teraknights/Pinkeybd-forked/other/README.md

# Pinkeybd
"Pinkeybd" is a portable wireless split keyboard with trackball
