teraknights/Pinkeybd-forked/other/docs/partslist_jp.md

## 1. パーツリスト

## 1.1 内容物

| 部品名 | 数量 | 通常版 | 組み立て済み版 | 最小構成版 |
| ---- | ----: | :----: | :----: | :----: |
| Pinkeybd 左手用基板 |1 | 〇 | ◎ | 〇 |
| Pinkeybd 右手用基板 |1 | 〇 | ◎ | 〇 |
| 左手用キーボードケース |1 | 〇 | ◎ | × |
| 右手用キーボードケース |1 | 〇 | ◎ | × |
| Seeed XIAO BLE nRF52840 |2 | × | ◎ | × |
| PMW3610 ブレイクアウトボード SEIBOKU（青墨） |1 | × | ◎ | × |
| PMW3610DM-SUDU |1 | × | ◎ | × |
| PMW3610DM Sensor With lens |1 | × | ◎ | × |
| THQWGD001 組み立て部品セット |1 | × | ◎ | × |
| XCL103使用3.3V出力昇圧DCDCコンバーターキット |2 | 〇 | ◎ | × |
| スライドスイッチ 1回路2接点 基板用 横向き |2 | 〇 | ◎ | 〇 |
| PHコネクター ベース付ポスト サイド型 2P S2B-PH-K-S |2 | 〇 | ◎ | 〇 |
| PHコネクター ハウジング 2P PHR-2 |2 | 〇 | ◎ | 〇 |
| PHコネクター コンタクト SPH-002T-P0.5L|4 | 〇 | ◎ | 〇 |
| チップ積層セラミックコンデンサー 47μF6.3V X5R 1608 |2 | 〇 | ◎ | 〇 |
| チップ積層セラミックコンデンサー 1μF6.3V X5R 1005 |2 | 〇 | ◎ | 〇 |
| カーボン抵抗(炭素皮膜抵抗) 1/4W 1MΩ |2 | 〇 | ◎ | 〇 |
| Wheel Encoder |1 | 〇 | ◎ | 〇 |
| Button Touch switch 6x6x7 |1 | 〇 | ◎ | 〇 |
| Cherry MX互換キースイッチ向けのキーソケット |35 | 〇 | ◎ | × |
| Kailh Choc V1向けのキーソケット |6 | 〇 | ◎ | × |
| 高速スイッチング・ダイオード 1N4148W |64 | 〇 | ◎ | × |
| トラックボールケース |1 | 〇 | 〇 | × |
| シャフトφ1.5 5mm |3 | 〇 | 〇 | 〇 |
| 電池カバー |2 | 〇 | ◎ | × |
| 電池ボックス 単3×1本 リード線 |2 | 〇 | ◎ | 〇 |
| 電源スイッチカバー |2 | 〇 | ◎ | × |
| マグネット 3mm × 2mm |32 | 〇 | 〇 | × |
| M2ネジ 6mm |6 | 〇 | ◎ | × |
| M2ネジ 8mm |14 | 〇 | ◎ | × |
| M2ナット |10 | 〇 | ◎ | ×
