teraknights/Pinkeybd-forked/other/case/Common/power_switch_cover.step

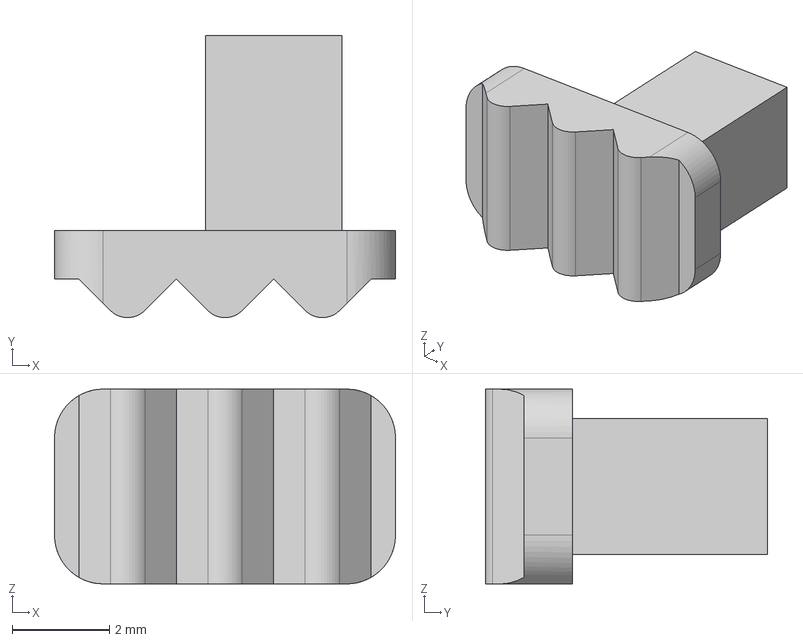
[picture p1: CAD file, 2026-01-10]
other/case/Common/power_switch_cover.step
7.00 x 5.79 x 4.00 mm
