teraknights/Pinkeybd-forked/other/case/Left/pinkeybd_L_ver2.1_top_plate.step

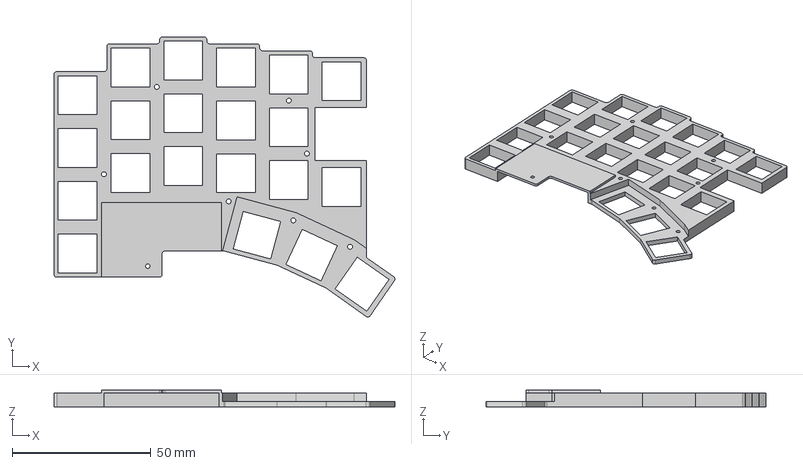
[picture p2: CAD file, 2026-01-10]
other/case/Left/pinkeybd_L_ver2.1_top_plate.step
123.0 x 101.1 x 6.00 mm
