teraknights/Pinkeybd-forked/other/case/Right/pinkeybd_R_ver2.1_bottom_case.step

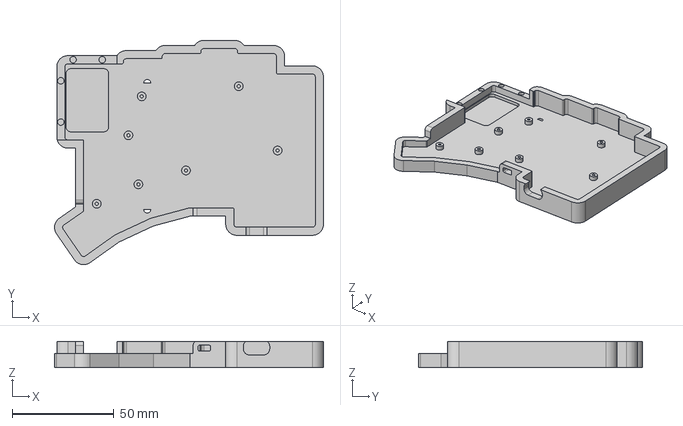
[picture p3: CAD file, 2026-01-10]
other/case/Right/pinkeybd_R_ver2.1_bottom_case.step
132.0 x 110.1 x 13.0 mm
