teraknights/Pinkeybd-forked/other/case/Common/battery_cover.step

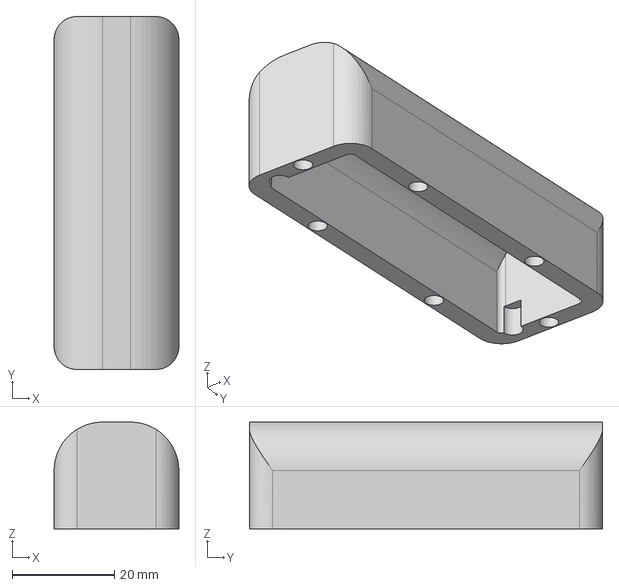
[picture p4: CAD file, 2026-01-10]
other/case/Common/battery_cover.step
24.4 x 69.0 x 20.9 mm
