teraknights/Pinkeybd-forked/other/case/Right/trackball_case.step

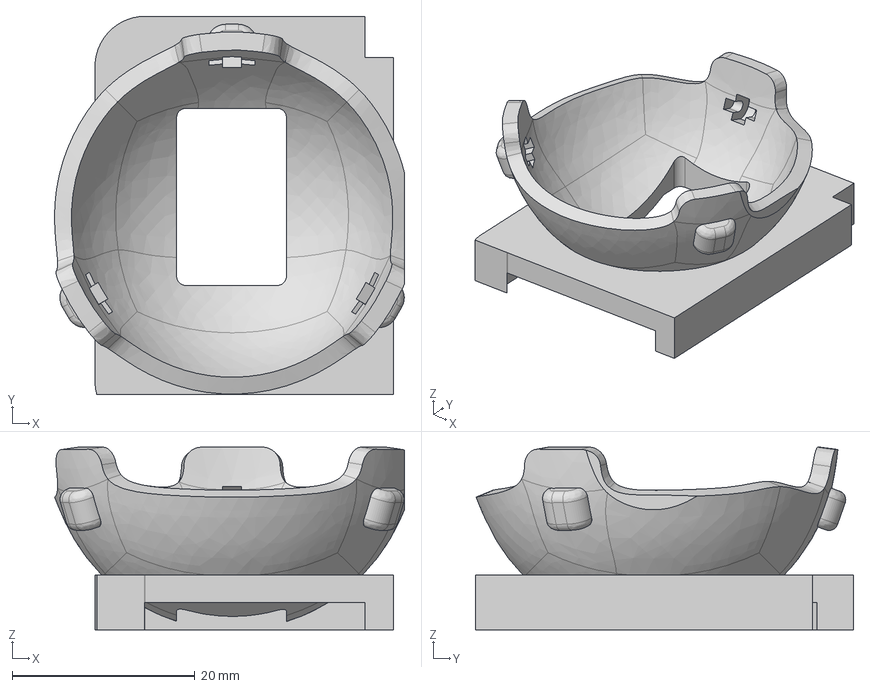
[picture p5: CAD file, 2026-01-10]
other/case/Right/trackball_case.step
38.3 x 41.4 x 20.0 mm
