teraknights/Pinkeybd-forked/(list of files, cad)

Other CAD files:
other/case/Left/pinkeybd_L_ver2.1_bottom_case.step
other/case/Right/pinkeybd_R_ver2.1_top_plate.step
other/case/Common/power_switch_cover.3mf
