teraknights/Pinkeybd-forked/other/docs/buildguide/buildguide_jp.md

Pinkeybdの通常版をご購入いただいた方向けのビルドガイドです。

# 0. 改定履歴
| 日付 | 内容 | 
| :----: | :---- |
| 2025/12/01 | 初版 |

# 1. 目次
- [0. 改定履歴](#0-改定履歴)
- [1. 目次](#1-目次)
- [2. 準備](#2-準備)
  - [2.1 内容物](#21-内容物)
  - [2.2 別途ご準備いただくもの](#22-別途ご準備いただくもの)
  - [2.3 その他あるとよいもの](#23-その他あるとよいもの)
  - [2.4 完成までに必要なもの](#24-完成までに必要なもの)
- [3. 実装](#3-実装)
  - [3.1 ダイオードのはんだ付け](#31-ダイオードのはんだ付け)
  - [3.2 キーソケットのはんだ付け](#32-キーソケットのはんだ付け)
  - [3.3 Xiaoの取り付け](#33-xiaoの取り付け)
  - [3.4 \[3.3V出力昇圧DCDCコンバーター\]の取り付け](#34-33v出力昇圧dcdcコンバーターの取り付け)
  - [3.5 電源スイッチの取り付け](#35-電源スイッチの取り付け)
  - [3.6 セラミックコンデンサの取り付け](#36-セラミックコンデンサの取り付け)
  - [3.7 抵抗の取り付け](#37-抵抗の取り付け)
  - [3.8 PHコネクタの取り付け](#38-phコネクタの取り付け)
  - [3.9 左手基板のロータリーエンコーダ](#39-左手基板のロータリーエンコーダ)
  - [3.10 トラックボール読み取りセンサの取り付け](#310-トラックボール読み取りセンサの取り付け)
  - [3.11 トラックボール読み取り基板の取り付け](#311-トラックボール読み取り基板の取り付け)
- [4. 仮動作確認](#4-仮動作確認)
  - [4.1 ファームウェアダウンロード](#41-ファームウェアダウンロード)
  - [4.2 ファームウェアの書き込み](#42-ファームウェアの書き込み)
  - [4.3 キーの動作確認](#43-キーの動作確認)
- [5. 組み立て](#5-組み立て)
  - [5.1 ボトムケースにマグネットを装着](#51-ボトムケースにマグネットを装着)
  - [5.2 電池ケースの配線](#52-電池ケースの配線)
  - [5.3 ボトムケースの準備](#53-ボトムケースの準備)
  - [5.4 基板とケースの組み立て](#54-基板とケースの組み立て)
  - [5.5 電池カバーケース](#55-電池カバーケース)
  - [5.6 電源スイッチカバー](#56-電源スイッチカバー)
  - [5.7 トラックボールケース](#57-トラックボールケース)
- [6. キースイッチとキーキャップ](#6-キースイッチとキーキャップ)
- [7. Bluetooth接続](#7-bluetooth接続)
- [8. ファームウェアの書き換えとキーマップ変更](#8-ファームウェアの書き換えとキーマップ変更)
- [9. トラブルシューティング](#9-トラブルシューティング)
- [10. Discordサーバ](#10-discordサーバ)

# 2. 準備
キットの内容物と別途準備いただくものを確認してください。

## 2.1 内容物
[パーツリスト](https://github.com/ktkhshi/Pinkeybd/blob/main/docs/partslist_jp.md)を参照ください。

## 2.2 別途ご準備いただくもの
| 部品名 | 数量 | 主な購入先|
| ---- | ----: | ---- |
|Seeed Xiao BLE nRF52840 | 2 | https://akizukidenshi.com/catalog/g/g117341/ |
|PMW3610 ブレイクアウトボード SEIBOKU（青墨） | 1 | https://booth.pm/ja/items/6363907?srsltid=AfmBOooXQEWyThINmj-5S1s9w4ln55OPvNEPTU_EjSfsdfYdSUeQe4cA |
|PMW3610DM-SUDU | 1| https://shop.talpkeyboard.com/products/pmw3610dm-sudu-lm18-lsi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 |
|PMW3610DM Sensor lens | 1 | 同上 |
|THQWGD001 組み立て部品セット | 1 | - |
|はんだごて | 1 | - |
|はんだ | 1 | - |
|ニッパー | 1 | - |
|圧着ペンチ | 1 | - |
|プラスドライバー | 1 | - |
|USB Type-C ケーブル | 1 | - |

## 2.3 その他あるとよいもの
| 部品名 | 数量 |
| ---- | ----: |
|ピンセット| 1|
|フラックス| 1|
|マスキングテープ| 1|
|細ペンチ | 1|

## 2.4 完成までに必要なもの
| 部品名 | 数量 | 主な購入先|
| ---- | ----: | ---- |
|ベアリング 内径 1.5mm 外径 4mm 幅 2mm  | 3 | https://amzn.to/4rdIJV1 |
|トラックボール 34mm  | 1 | https://amzn.to/4iEnzeT |
|キースイッチ | 41 | - |
|キーキャップ | 41 | - |

※Amazonのアソシエイトリンクを含みます

# 3. 実装
## 3.1 ダイオードのはんだ付け
ダイオードの向きに注意して、はんだ付けをします。
先に基盤の片側どちらかに予備はんだをしておき、予備はんだを溶かしながらつけていくとよいです。
ダイオードの数が多いですが、向きを間違えないように気を付けて行います。
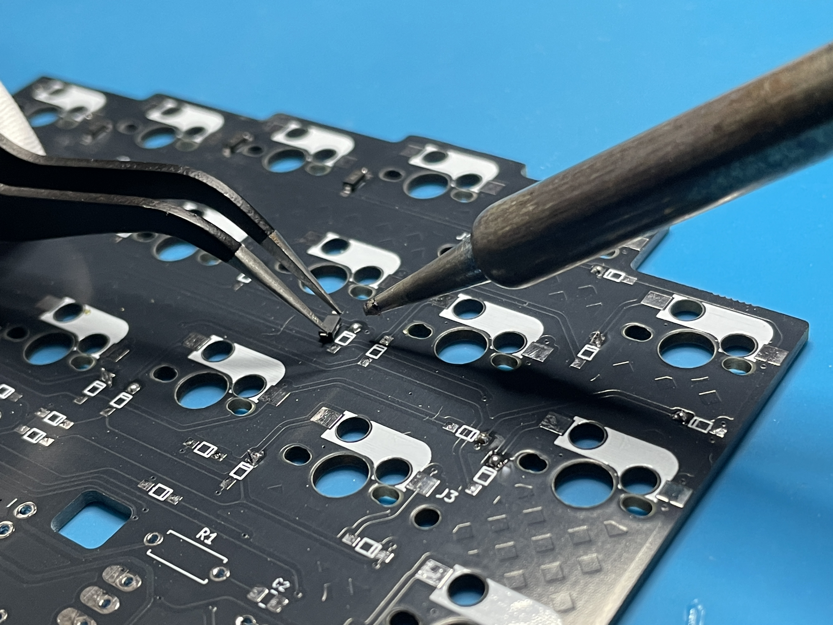
[picture p6: other/docs/buildguide/image/IMG_5378.JPG]


## 3.2 キーソケットのはんだ付け
Cherry MX互換キースイッチ向けのキーソケットをはんだ付けします。
こちらは、ソケットの設置箇所に予備はんだをしておき、はんだを溶かしながら押し込むとよいです。
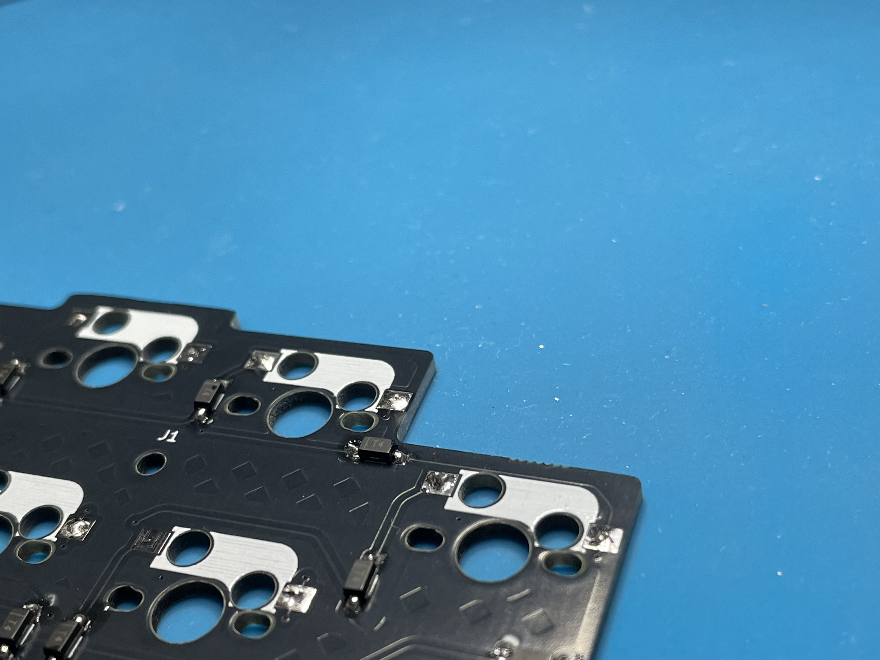
[picture p7: other/docs/buildguide/image/IMG_5383.JPG]


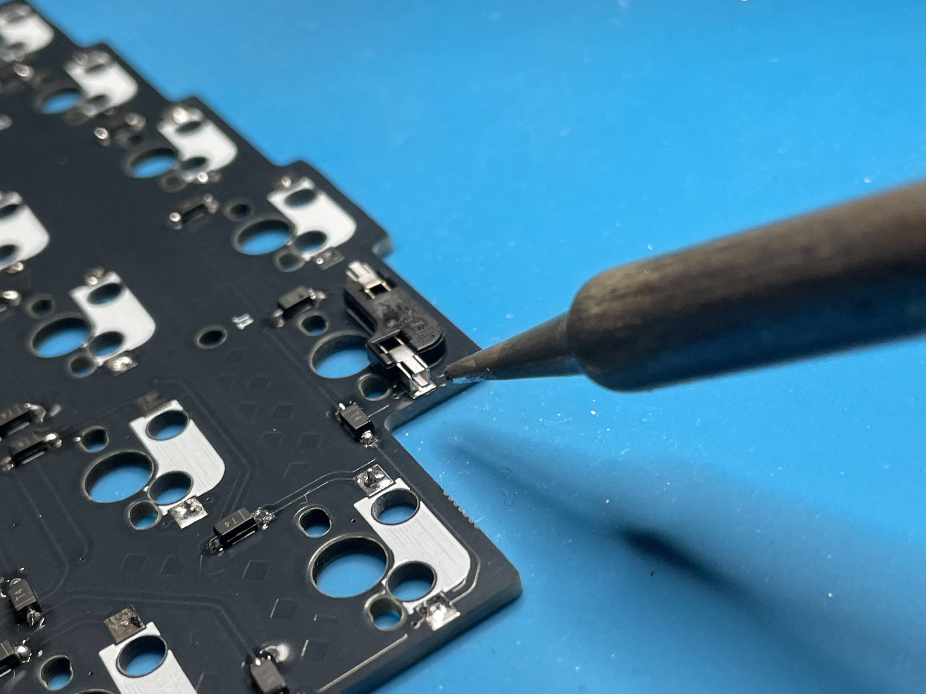
[picture p8: other/docs/buildguide/image/IMG_5384.JPG]


親指部分のKailh Choc V1向けのキーソケットも同様にはんだ付けします。
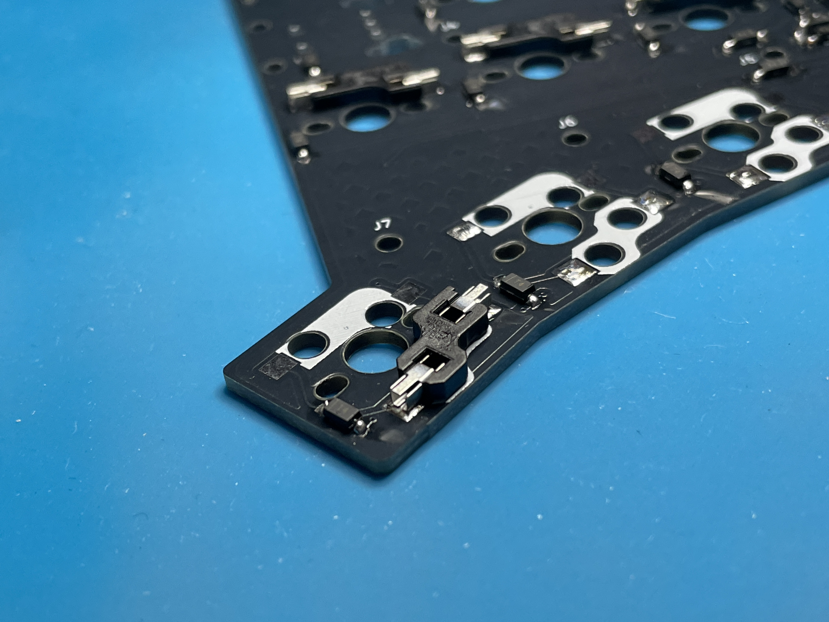
[picture p9: other/docs/buildguide/image/IMG_5388.JPG]


## 3.3 Xiaoの取り付け
基板の表面（ロゴが印字されている面）にSeeed Xiao BLE nRF52840を直接配置しピンヘッダーを差し込んでと固定します。
フラックスがある場合は、Xiaoのピン側面と基板のパッド部分に塗り隅の位置をはんだ付けします。
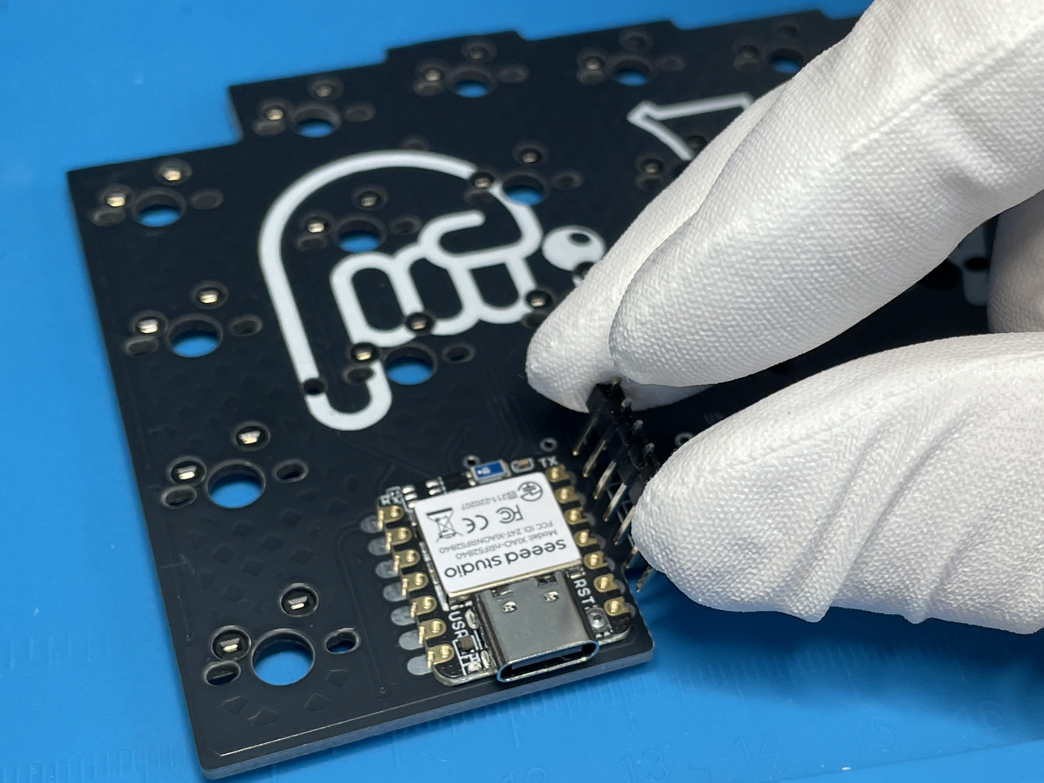
[picture p10: other/docs/buildguide/image/IMG_5402.JPG]


端のだけをはんだ付けしピンヘッダーを抜き、その他のピン部分をはんだ付けします。

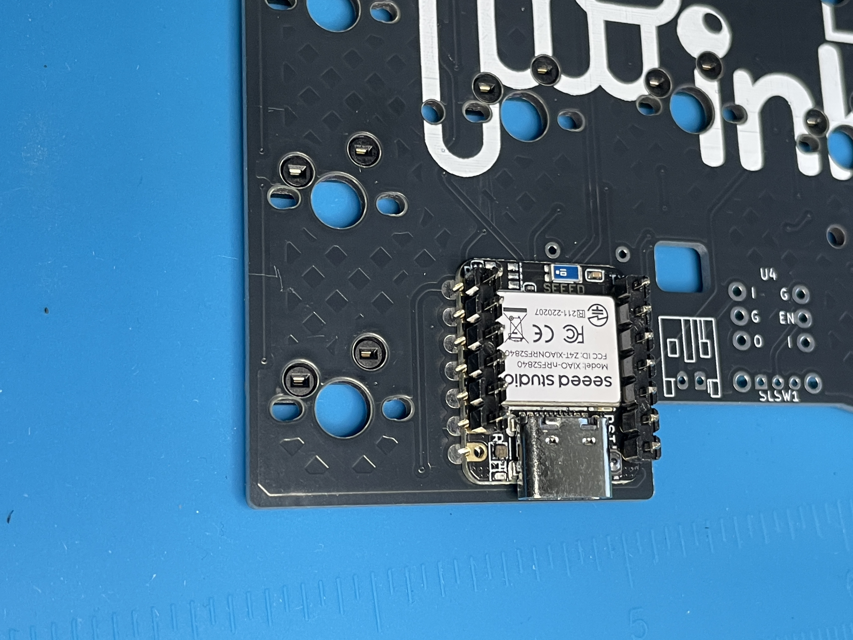
[picture p11: other/docs/buildguide/image/IMG_5409.JPG]


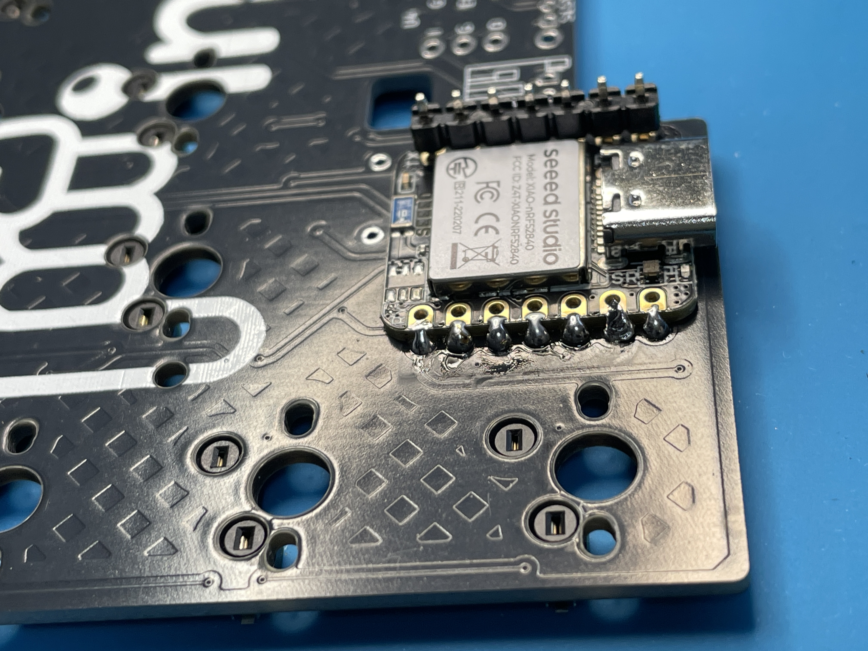
[picture p12: other/docs/buildguide/image/IMG_5416.JPG]


裏面の電源ピンのはんだ付けをします。フラックスがある場合は、フラックスをしっかり塗ってからはんだ付けします。すこし基板を傾けながら行うとやりやすいです。
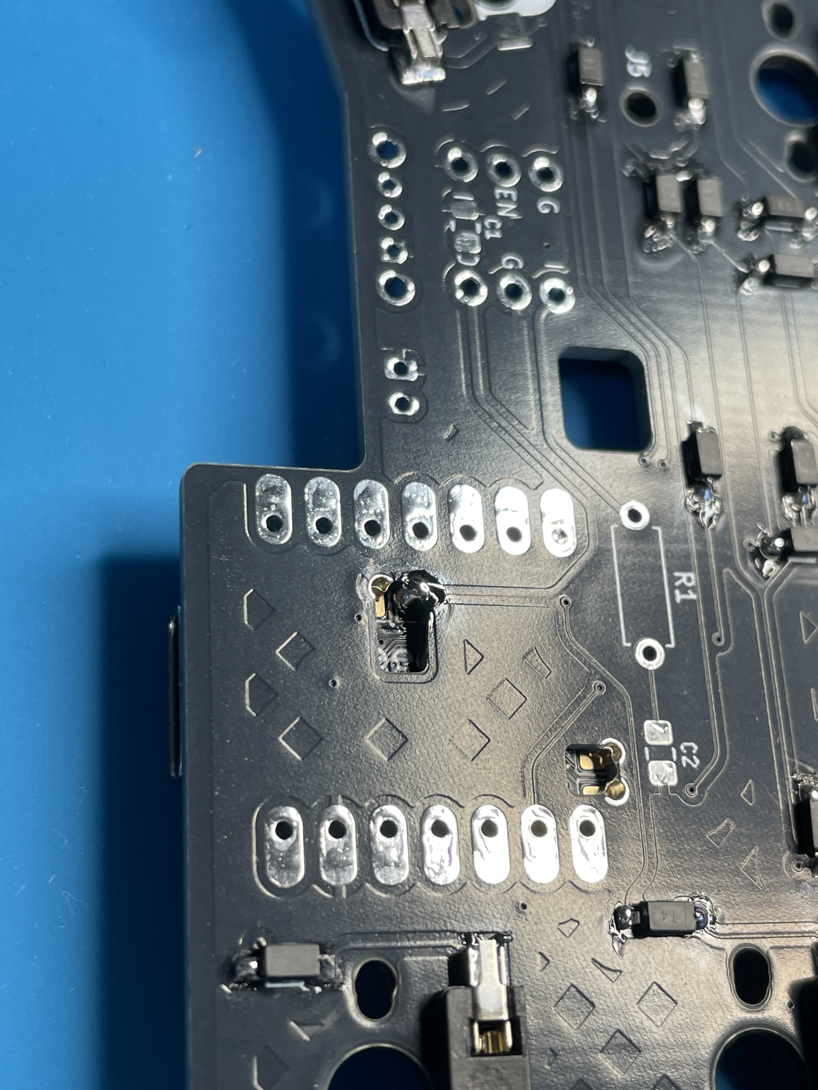
[picture p13: other/docs/buildguide/image/IMG_5421.JPG]


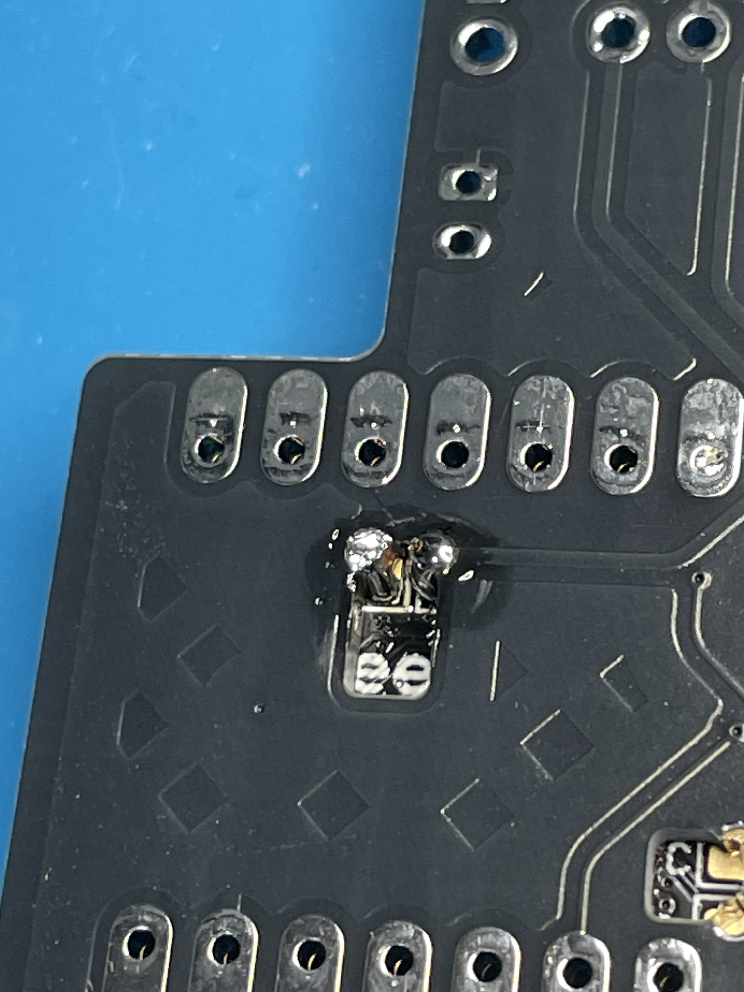
[picture p14: other/docs/buildguide/image/IMG_5423.JPG]


## 3.4 [3.3V出力昇圧DCDCコンバーター]の取り付け
ピンヘッダーを使用して3.3V出力昇圧DCDCコンバーターを基板の表面（ロゴが印字されている面）に取り付けます。
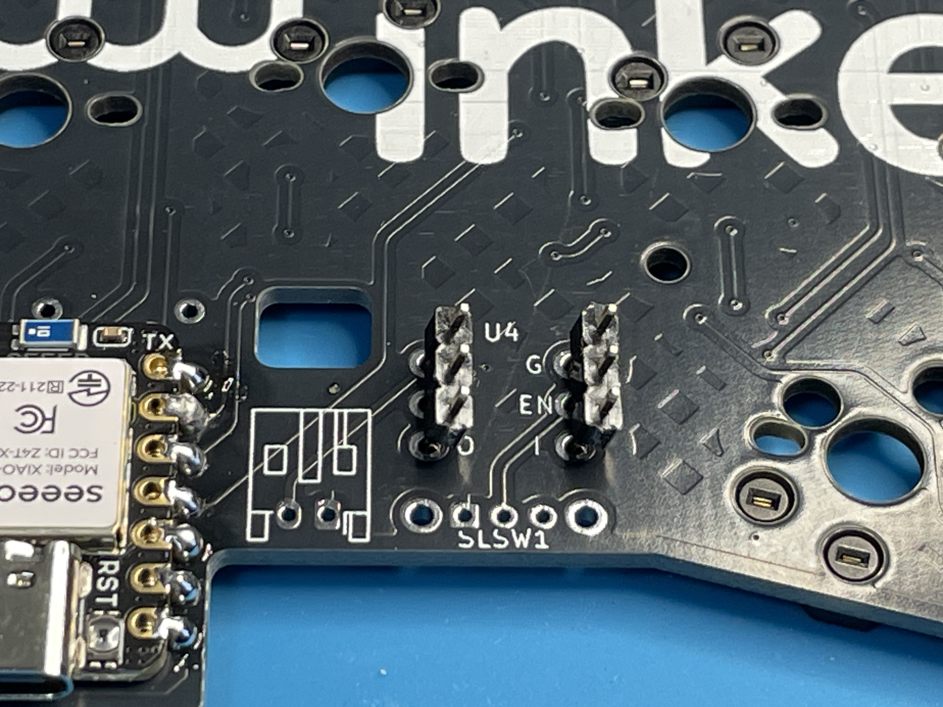
[picture p15: other/docs/buildguide/image/IMG_5424.JPG]


**必ず、基板に印字されているシルクと3.3V出力昇圧DCDCコンバーターのピンが一致していることを確認します。素子が付いている面をPinkeybdのメイン基板にしてください。** マスキングテープで3.3V出力昇圧DCDCコンバーターを固定し、基板の裏面をはんだ付けします。その後、テープを片面ずつ外しながら、3.3V出力昇圧DCDCコンバーターもはんだ付けします。

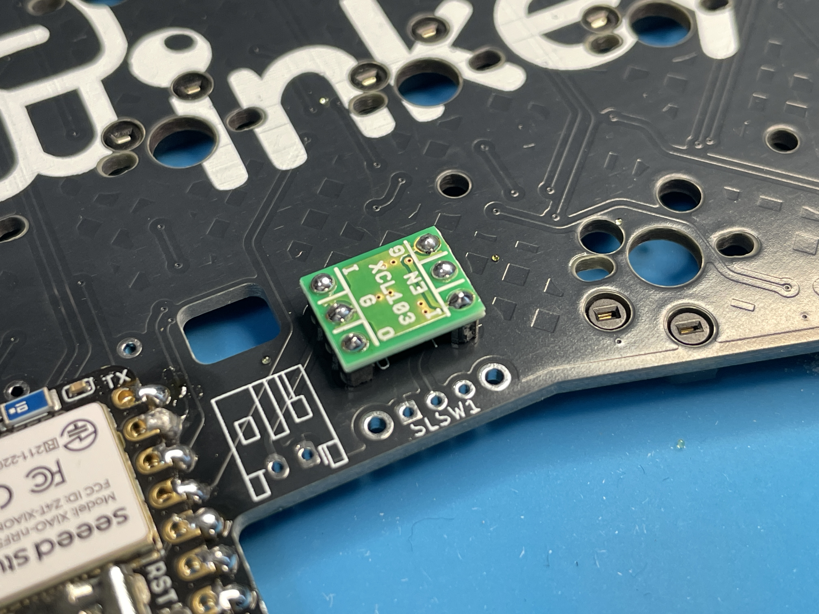
[picture p16: other/docs/buildguide/image/IMG_5432.JPG]


:::note alert 注意
左手基板の右下の「I」のピンははんだ付けしないようにしてください。
※画像では付けしておりますがEN側については、「G」と「EN」ピンのみとしてピンヘッダーを抜いて取り付けを行ってください。
※右手側はすべてのピンをはんだ付けして問題ありません。
:::

## 3.5 電源スイッチの取り付け
スライドスイッチを基板の表面（ロゴが印字されている面）から差し込みマスキングテープで固定して基板に取り付けます。

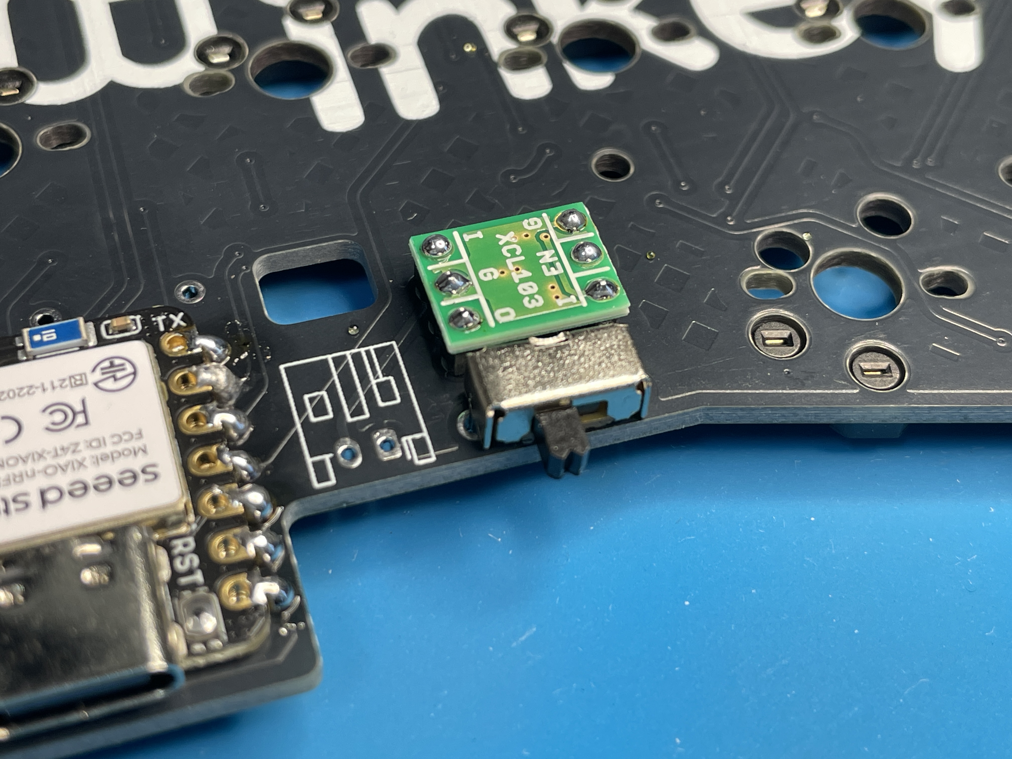
[picture p17: other/docs/buildguide/image/IMG_5435.JPG]


導通していない端の二つ足も固定のためにはんだ付けします。
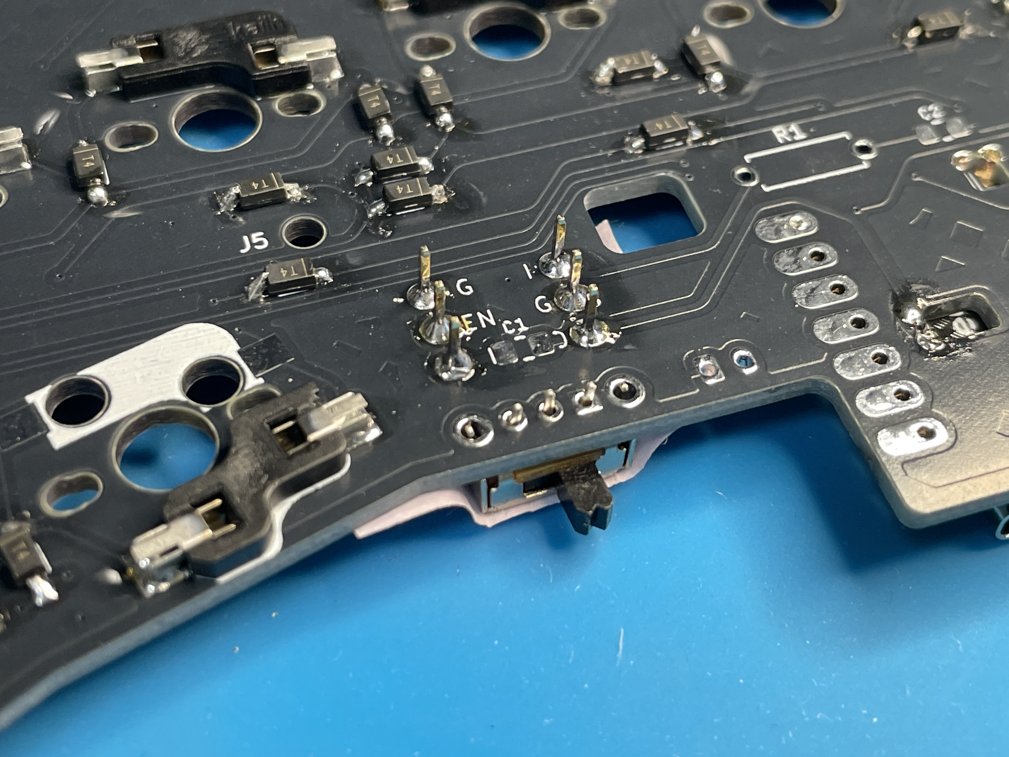
[picture p18: other/docs/buildguide/image/IMG_5437.JPG]


## 3.6 セラミックコンデンサの取り付け
C2の位置に1μFのセラミックコンデンサを取り付けます。
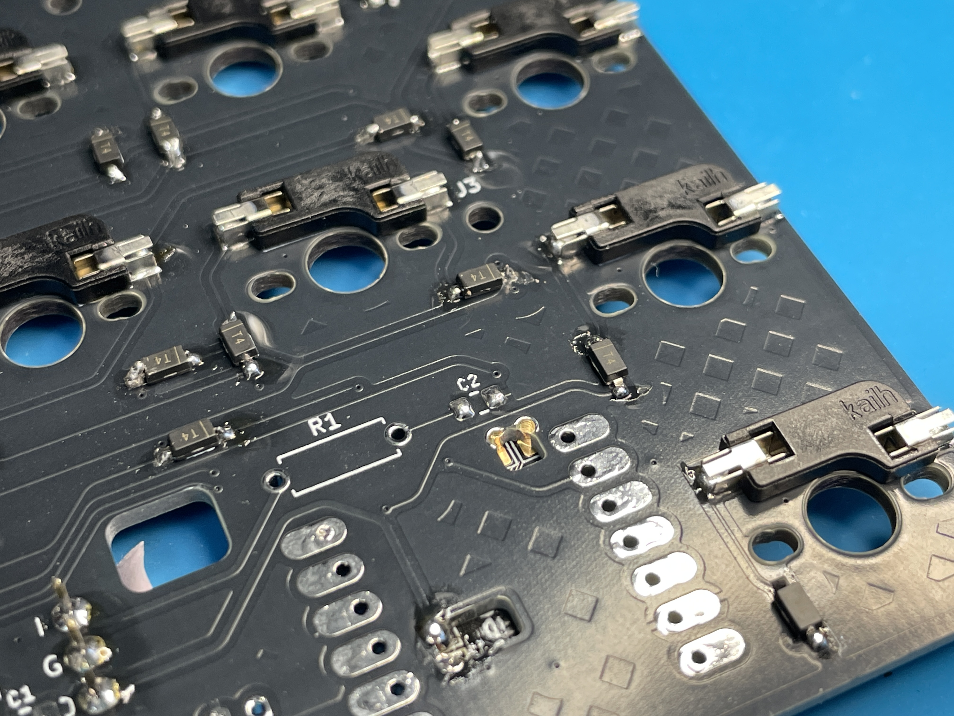
[picture p19: other/docs/buildguide/image/IMG_5439.JPG]


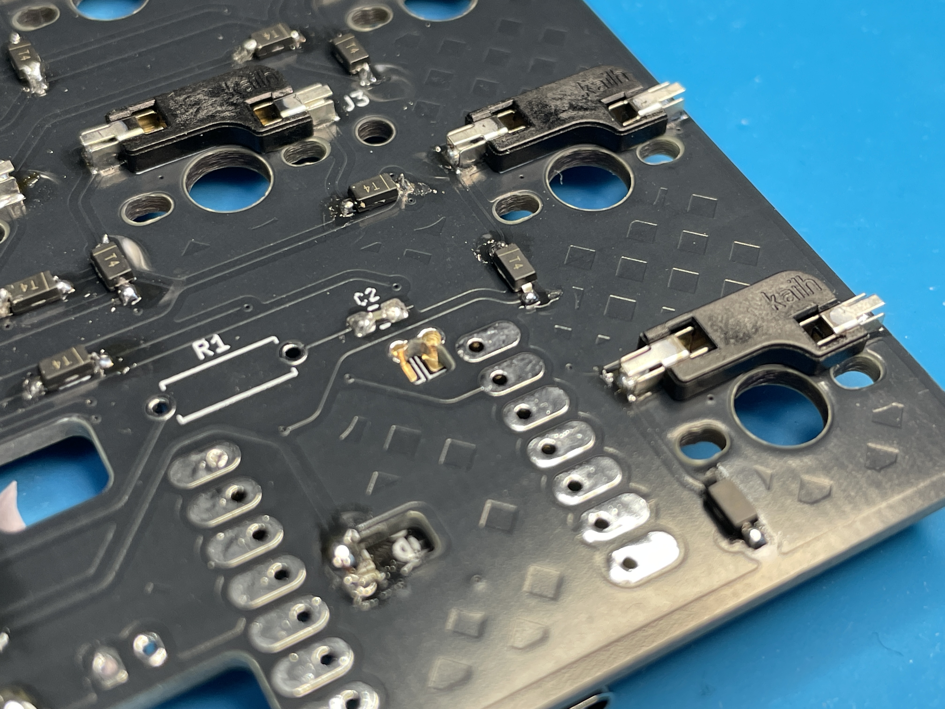
[picture p20: other/docs/buildguide/image/IMG_5440.JPG]
 

C1の位置に47μFのセラミックコンデンサを取り付けます。
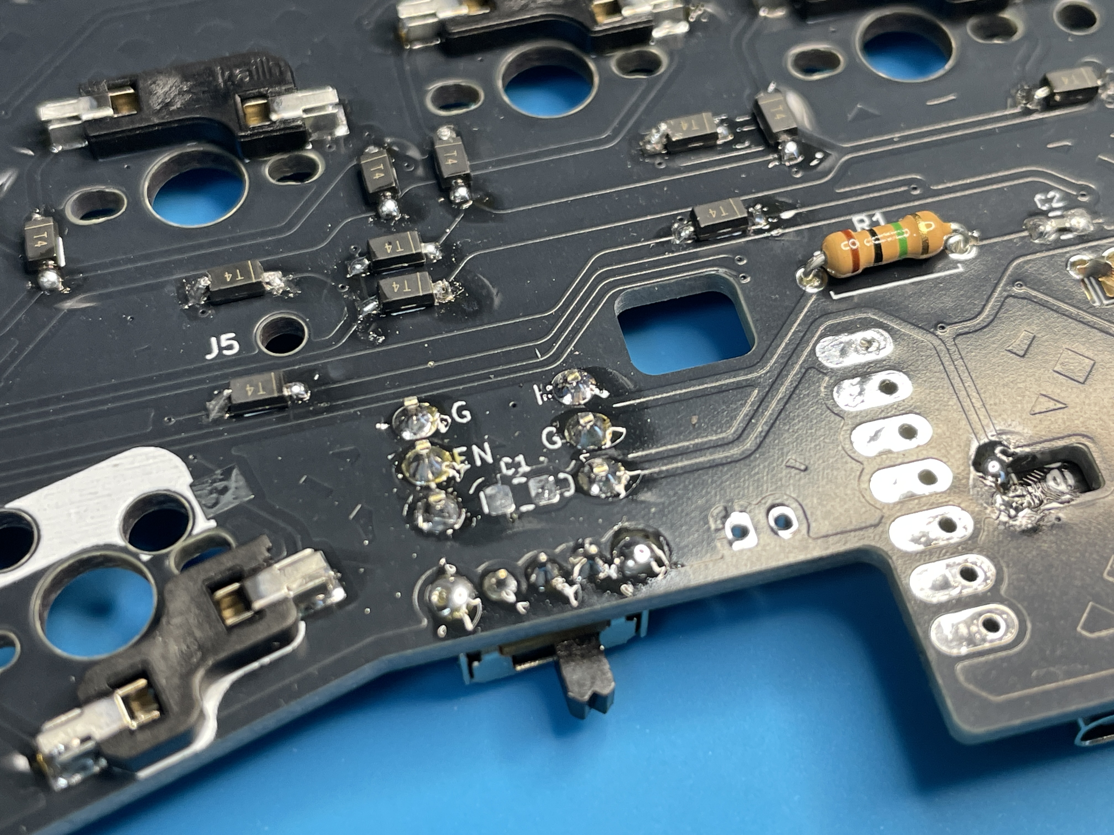
[picture p21: other/docs/buildguide/image/IMG_5449.JPG]


## 3.7 抵抗の取り付け
R1の位置にカーボン抵抗を取り付けます。
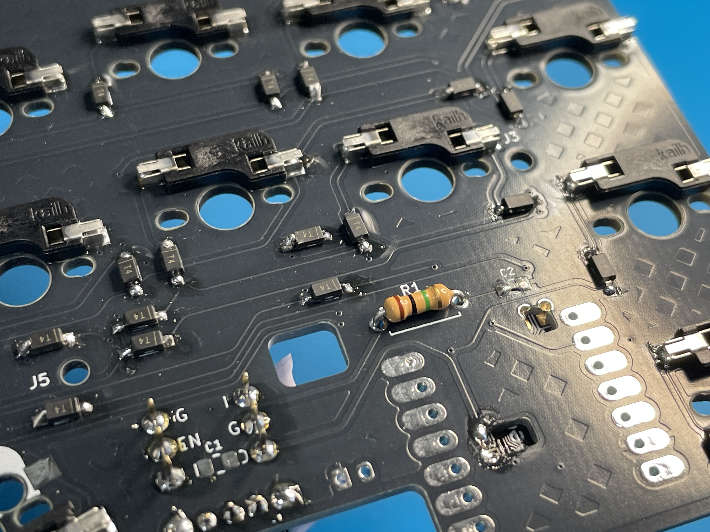
[picture p22: other/docs/buildguide/image/IMG_5444.JPG]

裏面から差し込み、表面ではんだ付けします。

## 3.8 PHコネクタの取り付け
PHコネクター ベース付ポストを基板にシルクの向きに合わせて裏面からはんだ付けします。
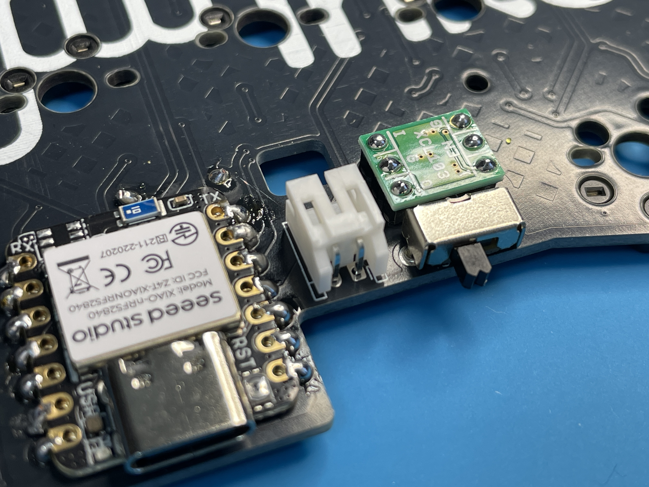
[picture p23: other/docs/buildguide/image/IMG_5452.JPG]


:::note 情報
3.1～3.6は、右手基板と左手基板で共通して行います。
:::

## 3.9 左手基板のロータリーエンコーダ
Wheel Encoderを基板に取り付けます。

先に、ホイールクリックのためのタクトスイッチをはんだ付けします。
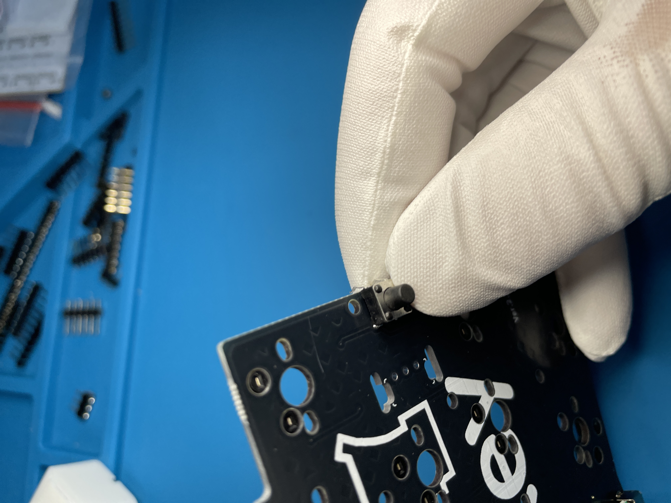
[picture p24: other/docs/buildguide/image/IMG_5457.JPG]

このとき片側の足だけを本体基板に挿し込みますができるだけ内側（基板中心）に寄せます。タクトスイッチがケースと干渉するのは防ぐためです。タクトスイッチのはんだ付けができたら、片側の足２本をニッパで切断します。
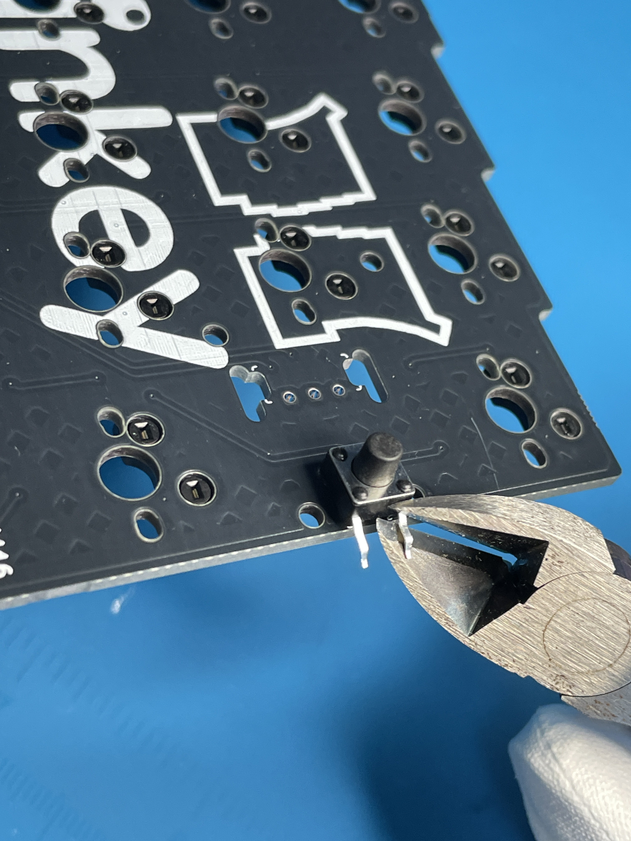
[picture p25: other/docs/buildguide/image/IMG_5461.JPG]


THQWGD001の部品を組み立てて、ナットのM2ねじで左手基板と固定します。
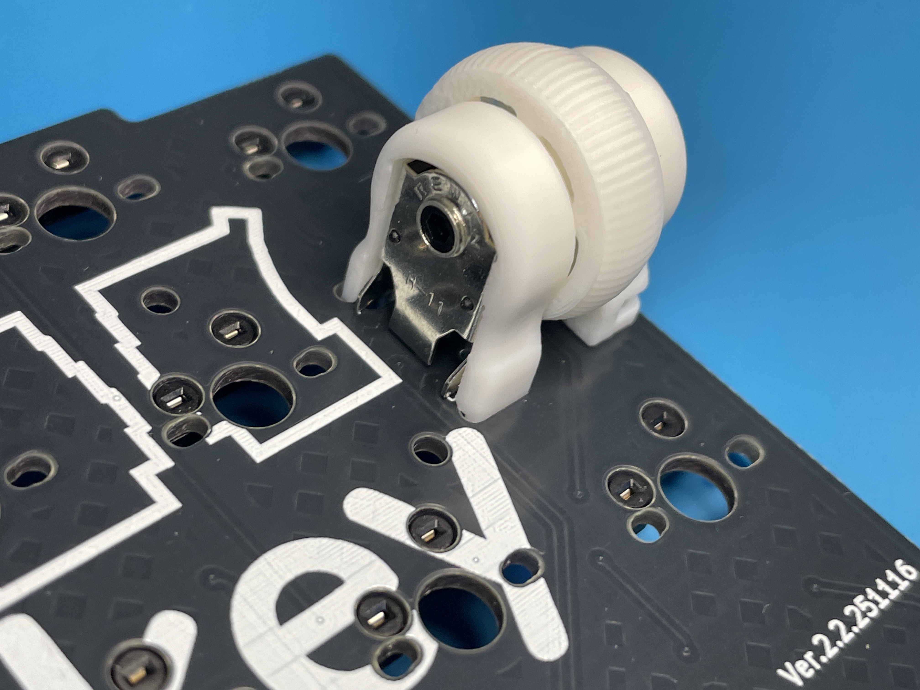
[picture p26: other/docs/buildguide/image/IMG_5463.JPG]


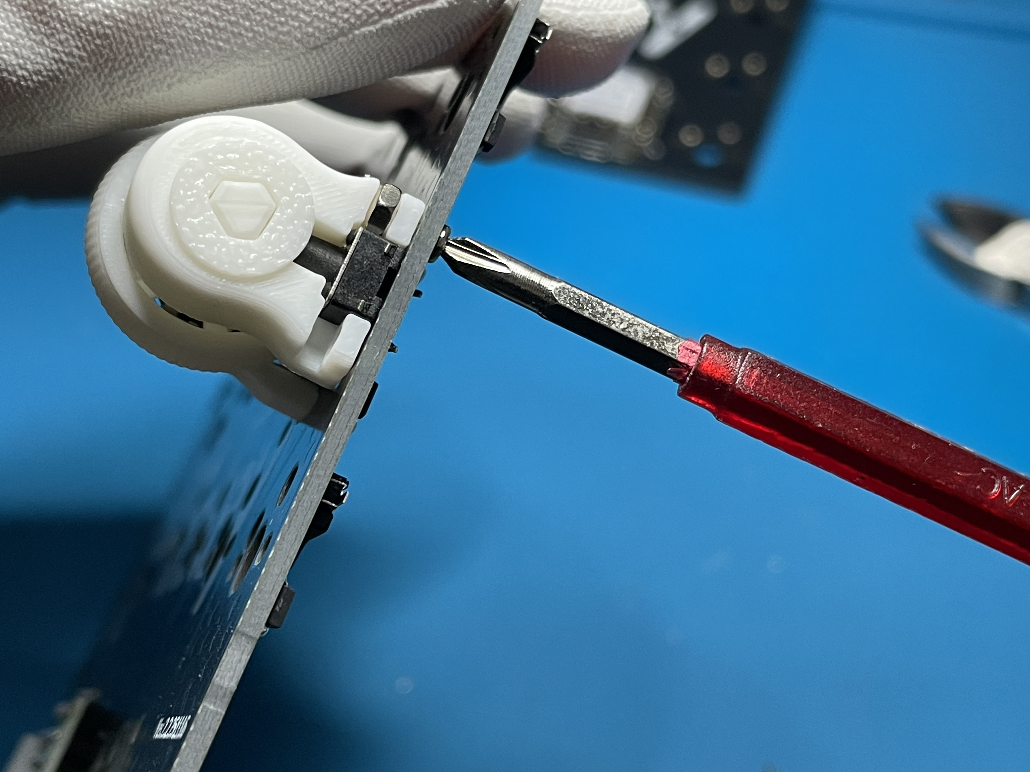
[picture p27: other/docs/buildguide/image/IMG_5510.JPG]


## 3.10 トラックボール読み取りセンサの取り付け
PMW3610 ブレイクアウトボード SEIBOKU（青墨）に、PMW3610DM-SUDUをはんだ付けします。
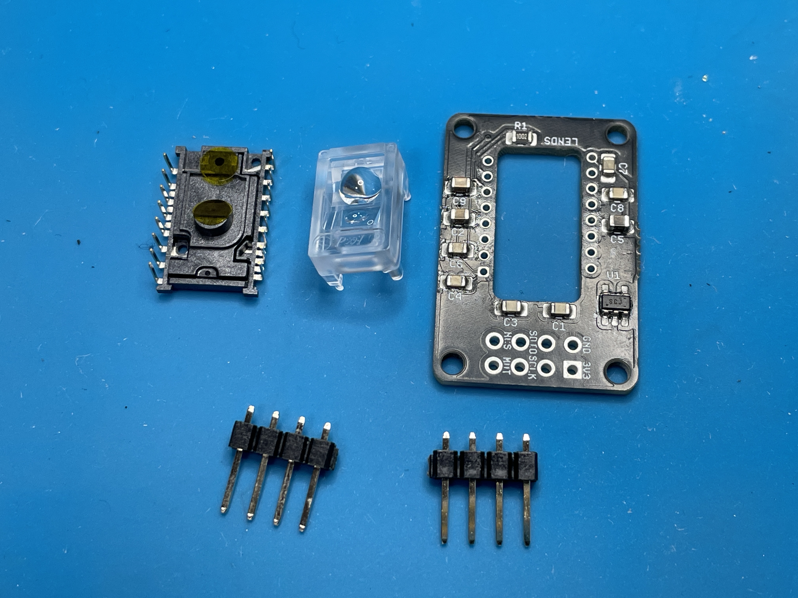
[picture p28: other/docs/buildguide/image/IMG_5491.JPG]


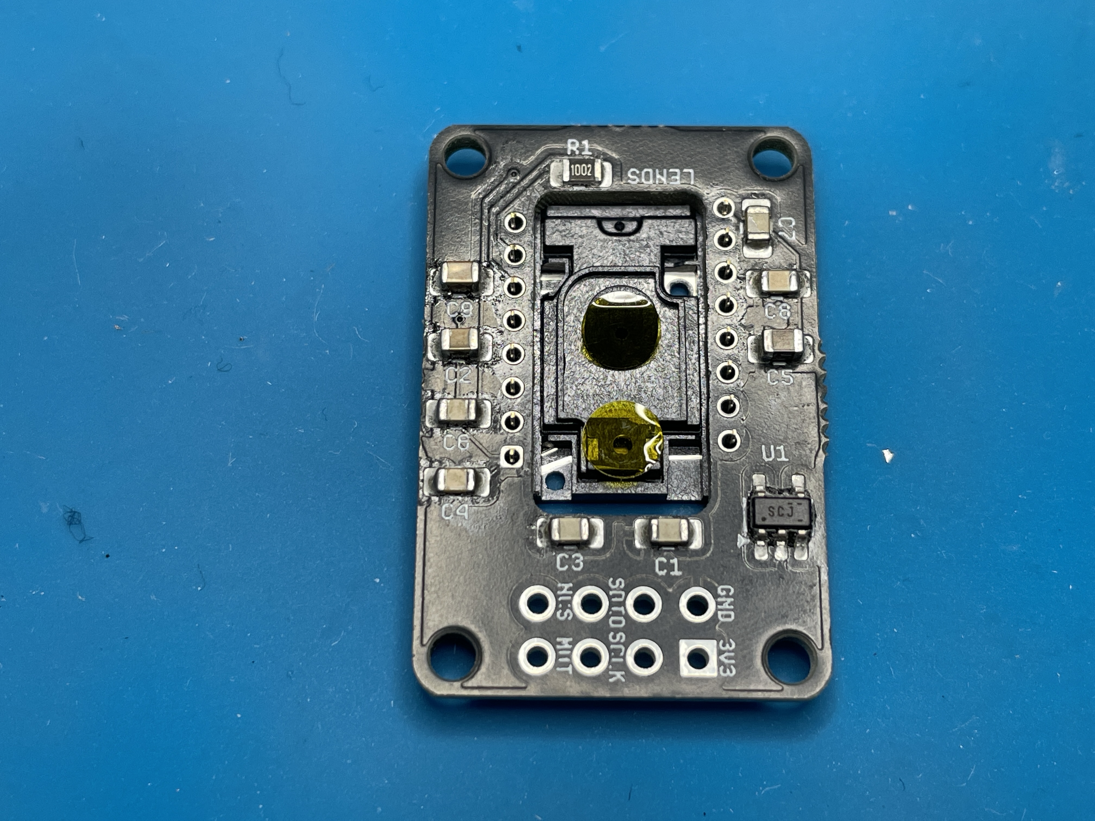
[picture p29: other/docs/buildguide/image/IMG_5493.JPG]

向きを間違えないようにします。はんだづけが完了したら、保護シールを外します。
※キーボードケース取り付け後でも問題ありません。

## 3.11 トラックボール読み取り基板の取り付け
PMW3610 ブレイクアウトボード SEIBOKU（青墨）を右手基板に取り付けます。
PMW3610 ブレイクアウトボード SEIBOKU（青墨）の四隅の穴にM2 8mmネジを通します。
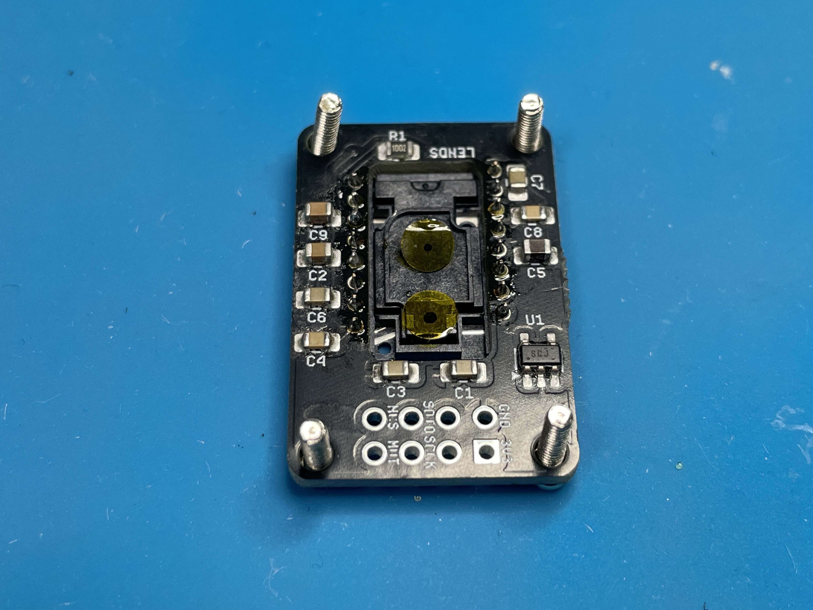
[picture p30: other/docs/buildguide/image/IMG_5494.JPG]


その上からナットを通して仮止めしてします。

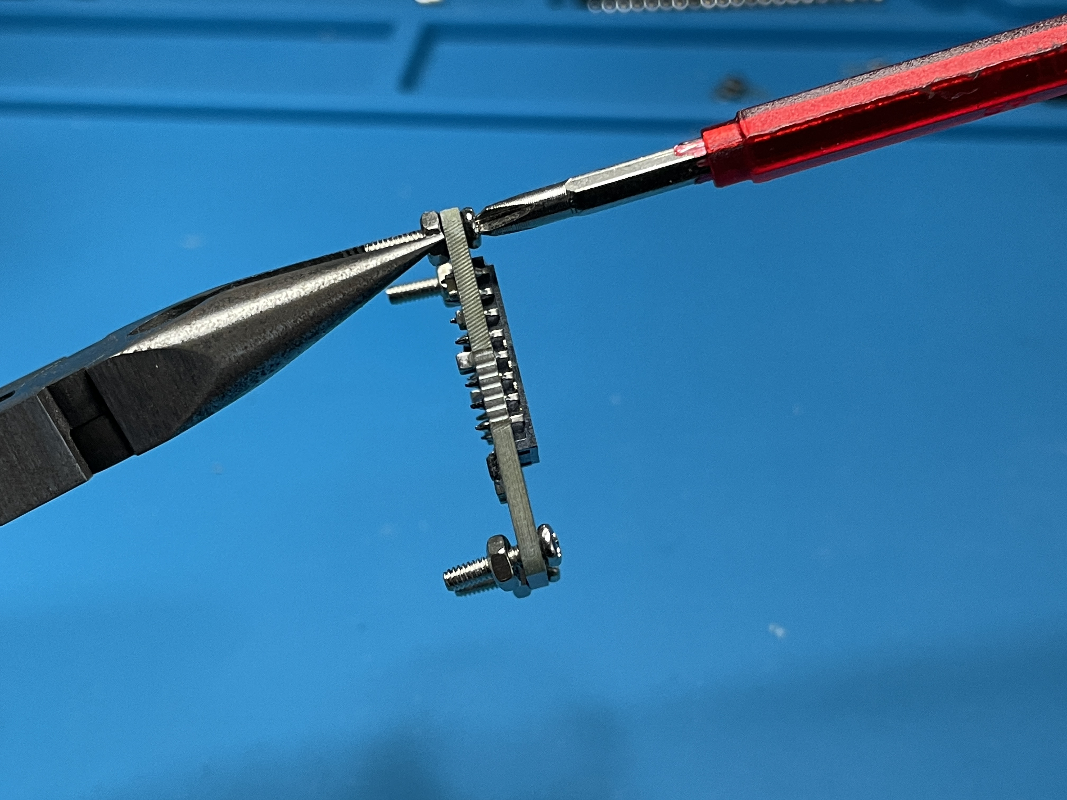
[picture p31: other/docs/buildguide/image/IMG_5497.JPG]


Pinkeybdの右手基板に裏面から差し込み、ナットで仮止めします。
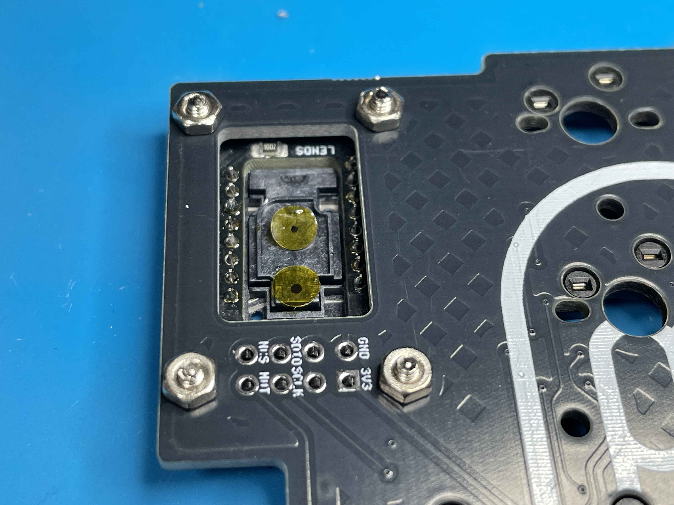
[picture p32: other/docs/buildguide/image/IMG_5500.JPG]


片側が長い４ピンのピンヘッダーを２つ使い右手基板の表面から挿してSEIBOKUのピン穴にも通します。
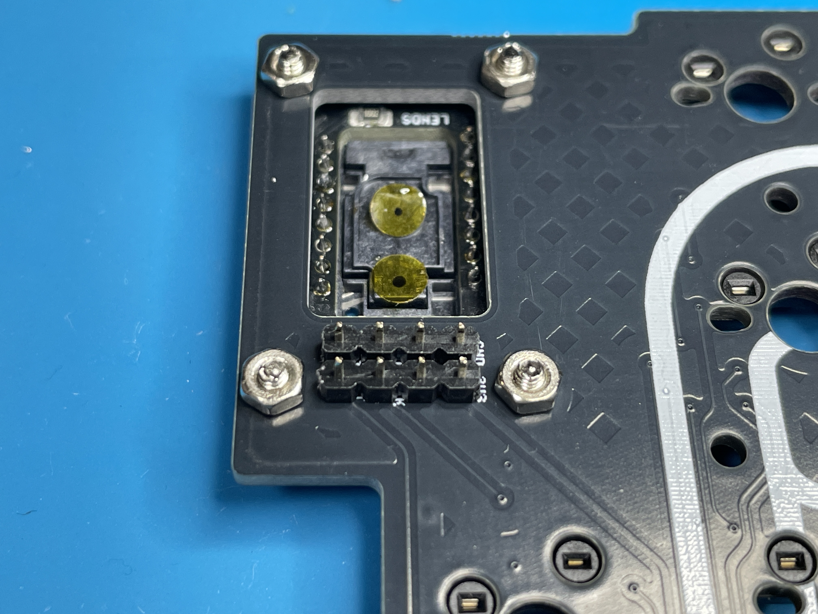
[picture p33: other/docs/buildguide/image/IMG_5502.JPG]


PMW3610 ブレイクアウトボード SEIBOKU（青墨）裏面のピンをはんだづけします。
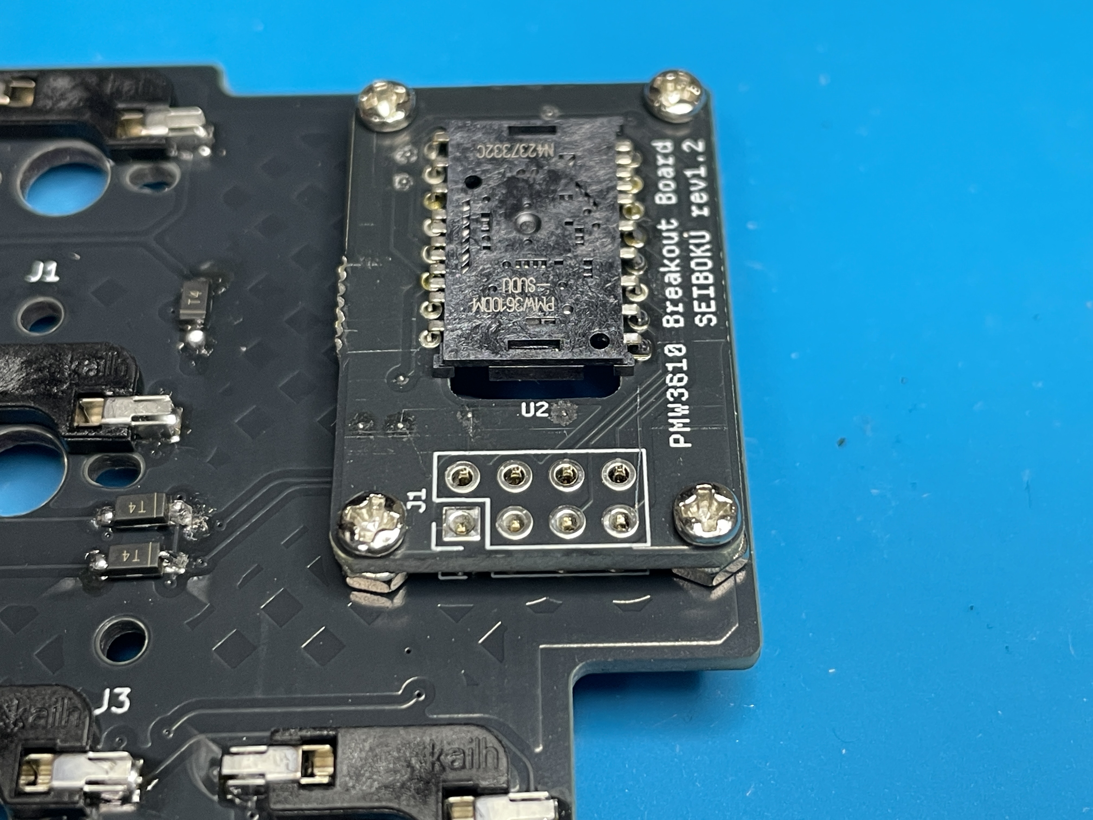
[picture p34: other/docs/buildguide/image/IMG_5504.JPG]


表面にしてピンヘッダーのハウジング（外装）部分を取り外して、基板側もはんだ付けします。
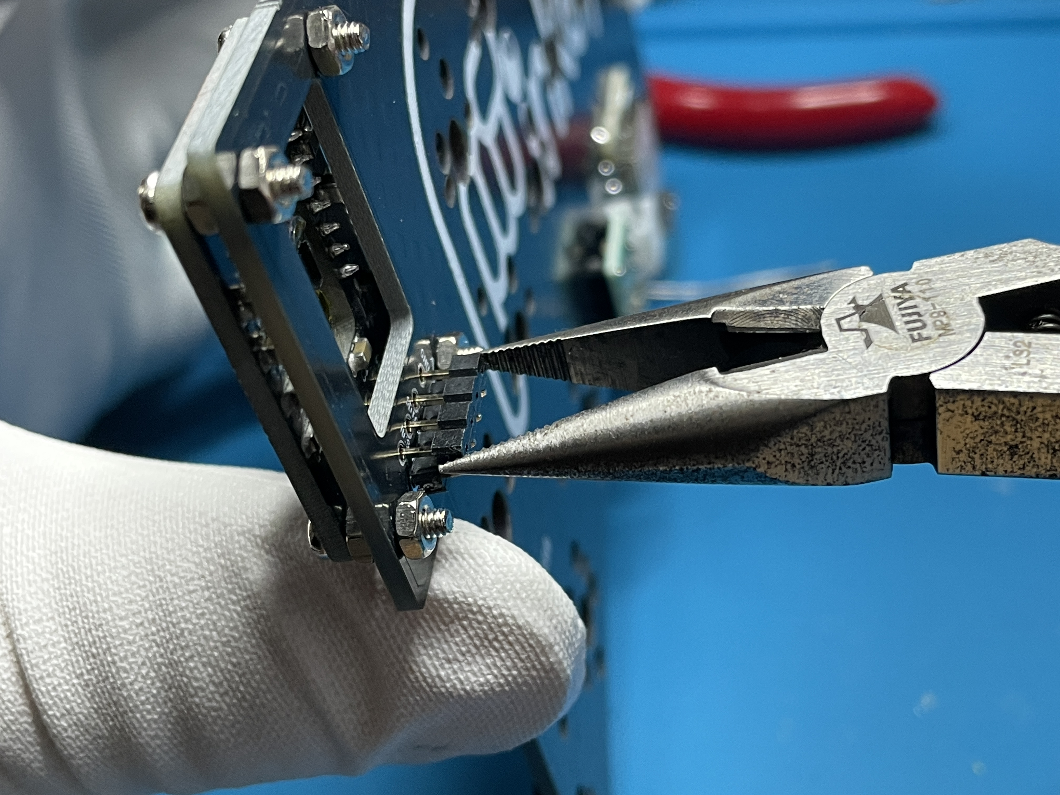
[picture p35: other/docs/buildguide/image/IMG_5506.JPG]


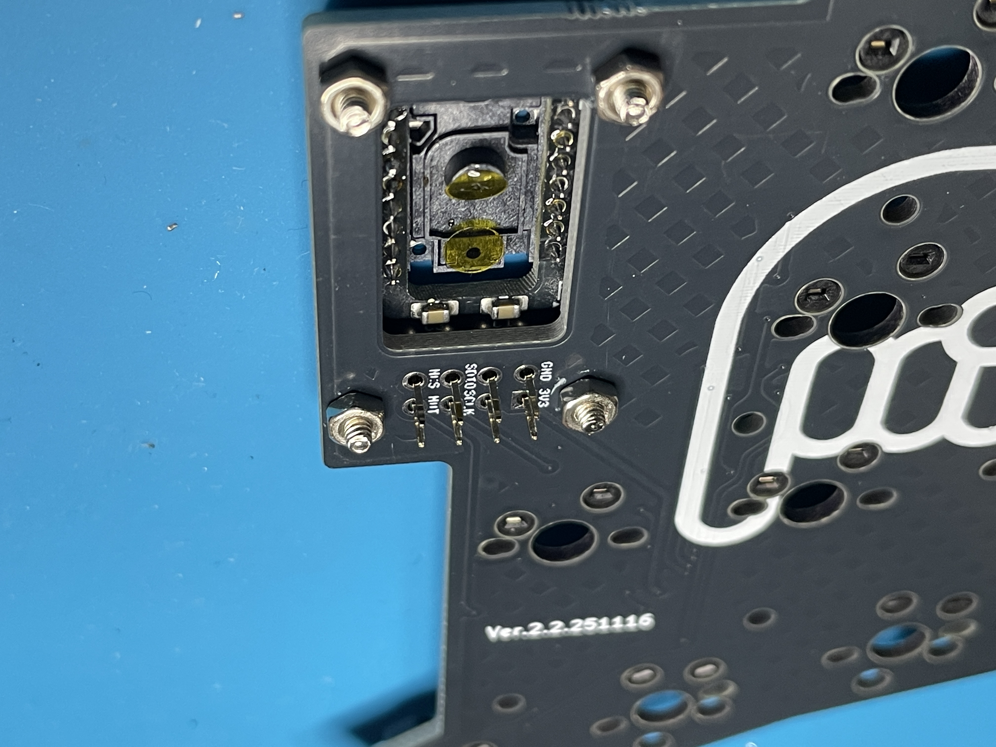
[picture p36: other/docs/buildguide/image/IMG_5507.JPG]


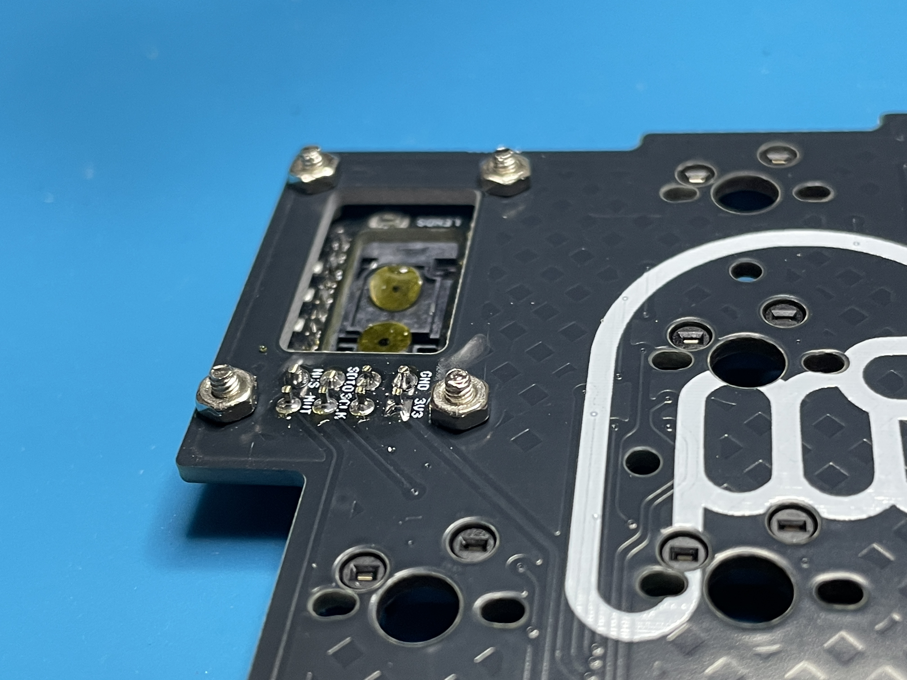
[picture p37: other/docs/buildguide/image/IMG_5508.JPG]


# 4. 仮動作確認
## 4.1 ファームウェアダウンロード
この時点で仮で動作確認を行います。
下記リンクからビルド済みのファームウェアをダウンロードしてください。

## 4.2 ファームウェアの書き込み
左手用基板のXiaoのUSB Type-C（データ転送対応用）とコンピュータを接続し、リセットボタンをダブルクリックします。
ダウンロードした.uf2ファイル（左手用）をコピーします。
右手用ファイルには右手のXiaoにコピーします。

## 4.3 キーの動作確認
左右それぞれのXiaoにUSB Type-Cで接続し各キーが反応することを確認します。
反応しないキーが存在していた場合、はんだ付けになんらかの問題があるか可能性があります。

# 5. 組み立て
## 5.1 ボトムケースにマグネットを装着
ボトムケースの裏面にマグネットを挿入する穴が6つあります。
そこにマグネットを装着します。
穴はマグネットがぴったり（すぎる程）収まるサイズで、挿入時にはすこし強く押し込む必要があります。また、一度挿入すると簡単に抜けません。
N極、S極をどちらのするのか決めて装着してください。
向きを間違えないようにするために、あらかじめ片側に印をつけてから行います。
左右のケースを背中合わせでくっつけたい場合（この場合は電池ケースは左右で共有できない）と、電池ケースカバーを左右どちらも装着できるようにする場合（この場合は左右のケースを背中合わせでくっつけることができない）を選択し、装着します。
この作業は、組み立て作業の最後に行っても問題ありません。

## 5.2 電池ケースの配線
電池ケースとPHコネクタハウジングを作成します。
まず、電池ケースのリード線をケースの裏側から通します。


リード線の先端にPHコネクターコンタクトをはんだ付けします。
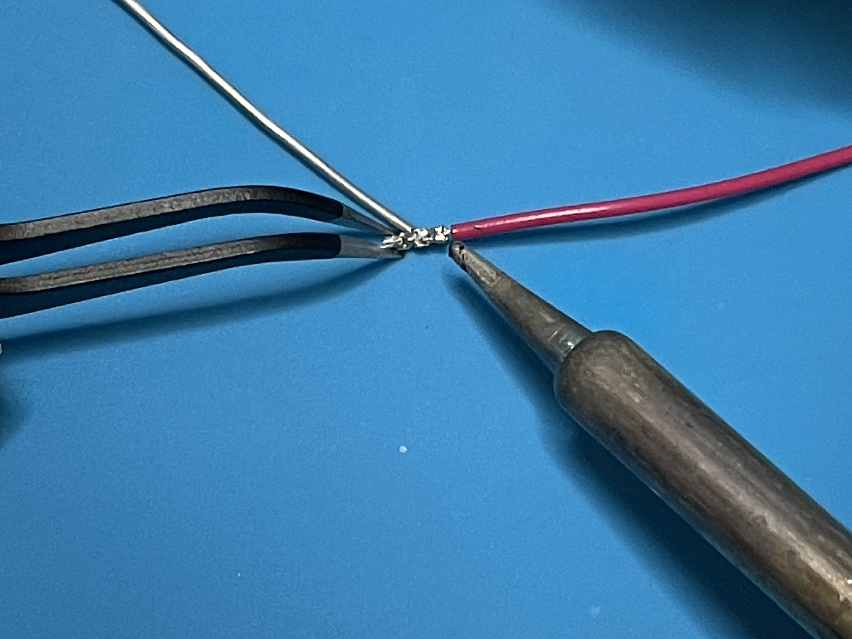
[picture p39: other/docs/buildguide/image/IMG_5532.JPG]


圧着ペンチを使ってリード線とPHコネクターコンタクトを圧着します。
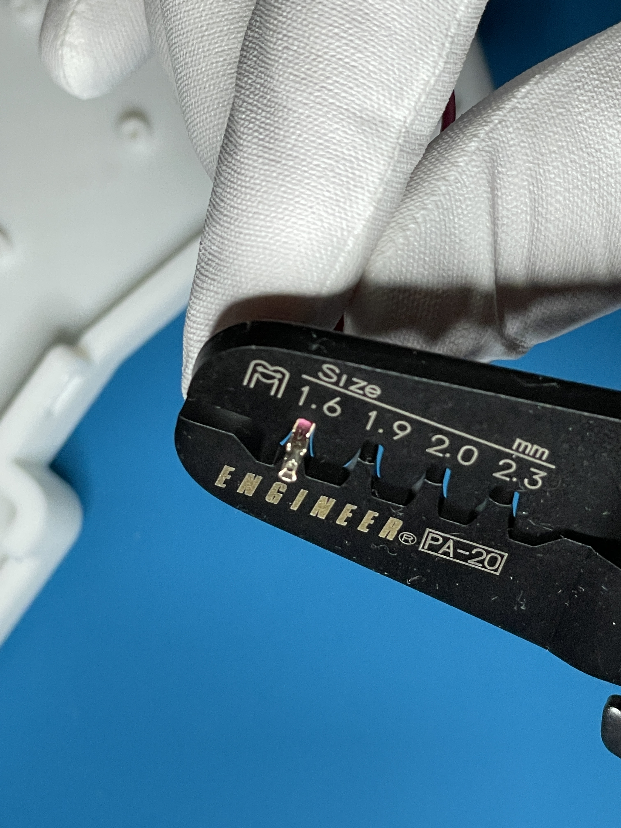
[picture p40: other/docs/buildguide/image/IMG_5527.JPG]


PHコネクター ハウジングに装着します。
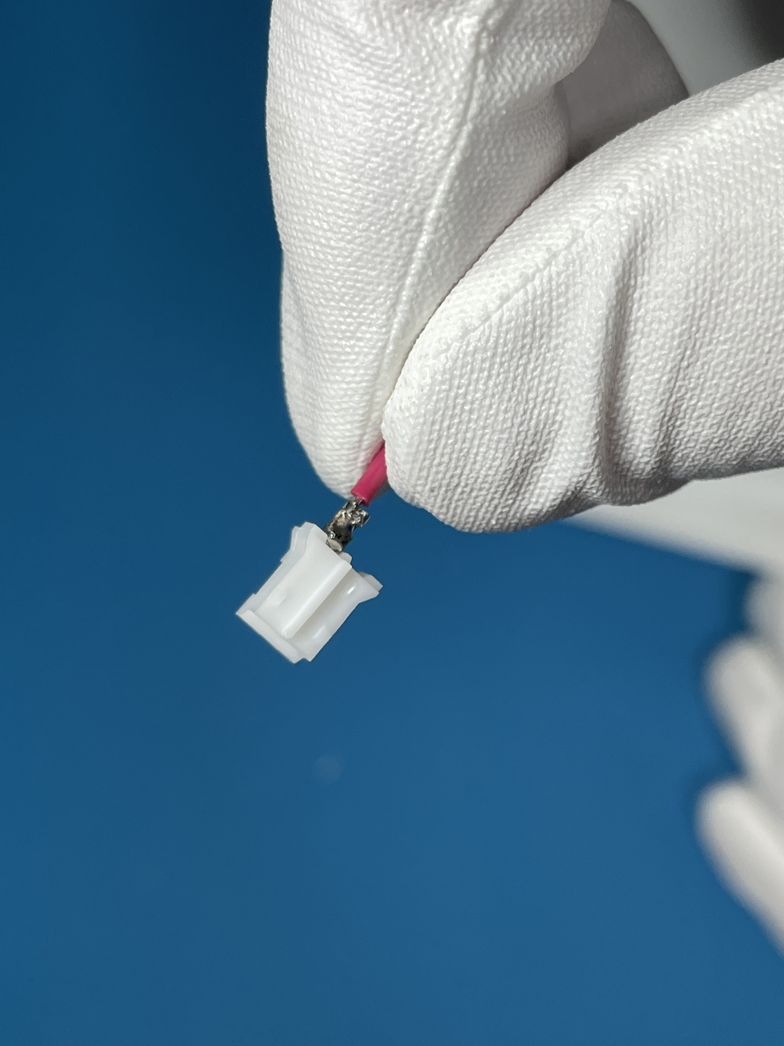
[picture p41: other/docs/buildguide/image/IMG_5536.JPG]

必ず、差し込む向きに線がある方を上側にしたとき、右側を赤いリード線（電池のプラス側）となるように差し込みます。
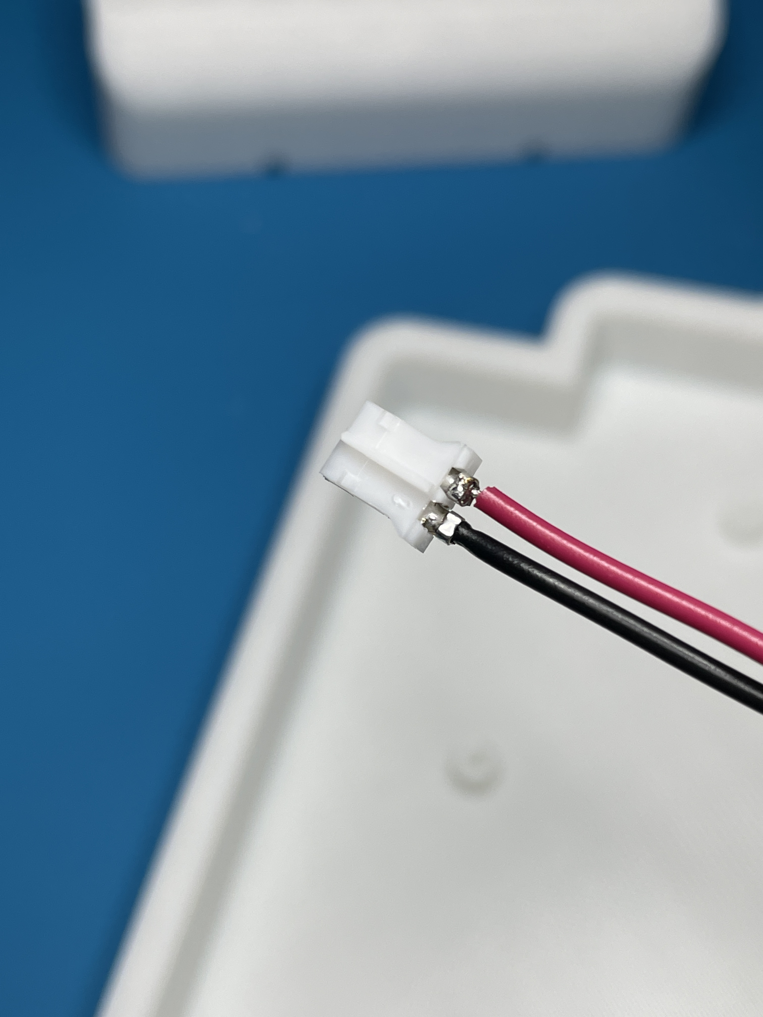
[picture p42: other/docs/buildguide/image/IMG_5537.JPG]

左手用も右手用も両方同じように配線します。

## 5.3 ボトムケースの準備
ボトムケースに映えているネジを差し込む用の穴に、M2ネジを使ってねじ溝を作成します。数ミリ程度、ねじを挿入して反対に回して抜きます。


右手用ケースと左手用ケースをそれぞれ7箇所ずつ行います。

## 5.4 基板とケースの組み立て
PHコネクターハウジングを基板裏から四角い穴から通しておきます。
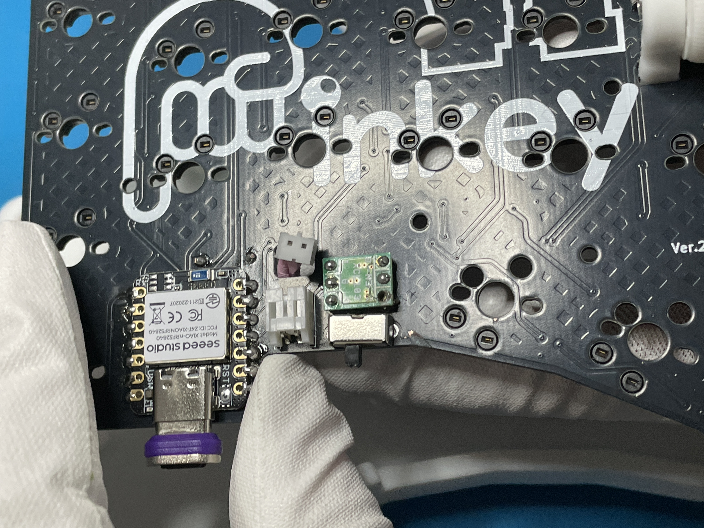
[picture p44: other/docs/buildguide/image/IMG_5545.JPG]


基板をボトムケースにはめ込みます。
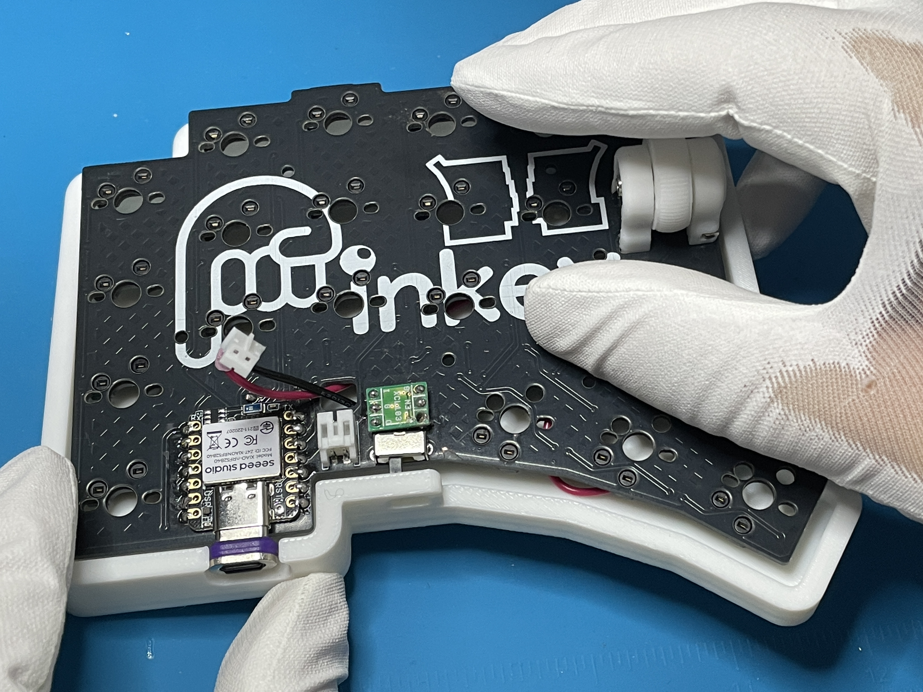
[picture p45: other/docs/buildguide/image/IMG_5548.JPG]

このとき、電源スイッチがボトムケースに引っかかることがあるので
下側（電源スイッチ側）から先に差し込むようにして基板をはめ込みます。
PHコネクターハウジングを基板のPHコネクターに挿入します。
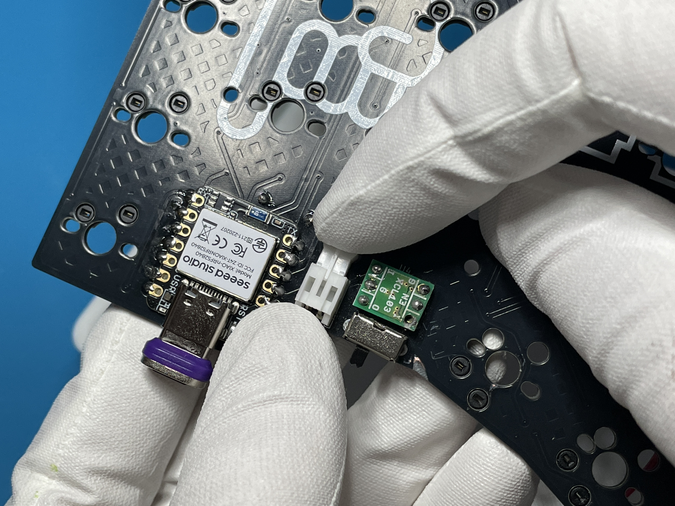
[picture p46: other/docs/buildguide/image/IMG_5556.JPG]

トッププレートを上からかぶせます。
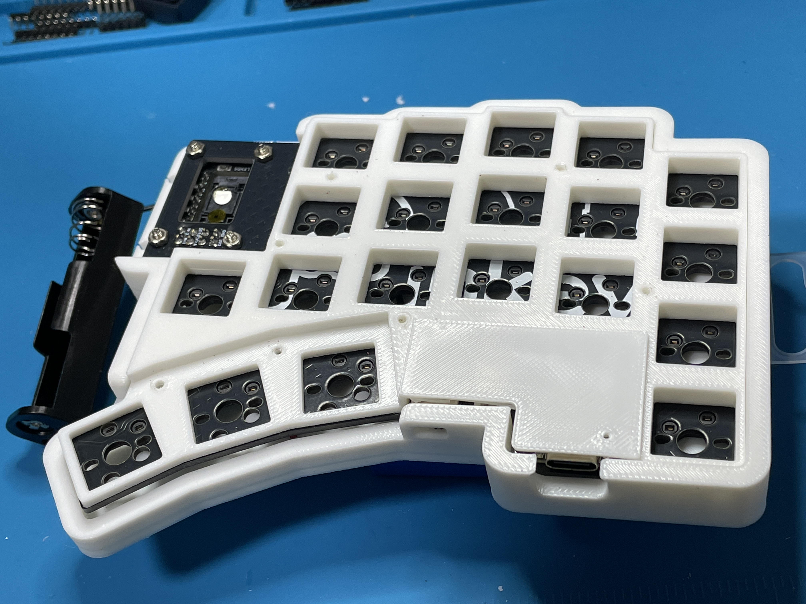
[picture p47: other/docs/buildguide/image/IMG_5576.JPG]

キースイッチを四隅にはめ込み位置を固定します。
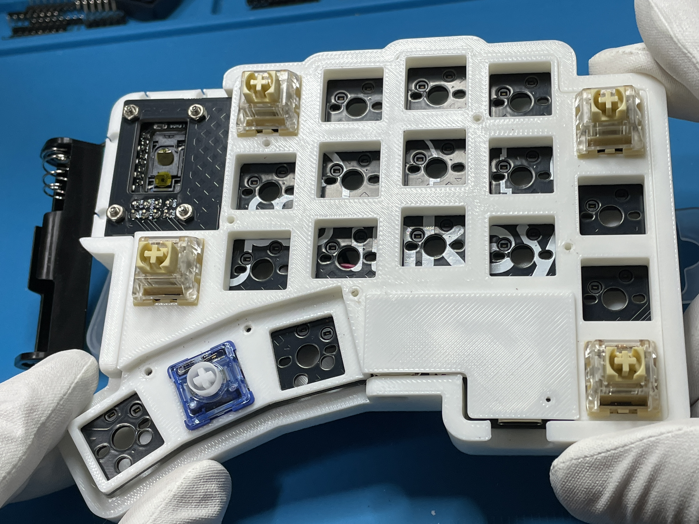
[picture p48: other/docs/buildguide/image/IMG_5578.JPG]

M2 8mmのねじで5箇所（両手10箇所）、M2 6mmのネジで親指部分の2箇所（両手2箇所）を仮ネジ止めします。
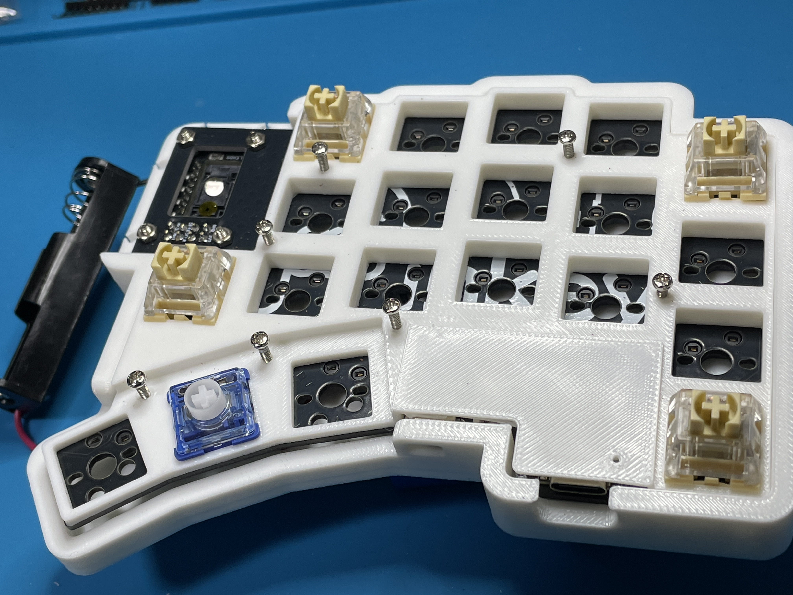
[picture p49: other/docs/buildguide/image/IMG_5580.JPG]

ボトムケースとトッププレートの位置がずれないように位置を調整しながら、ネジを挿入します。トップレートが浮いてしまう場合は少し抑えながらネジを挿入します。
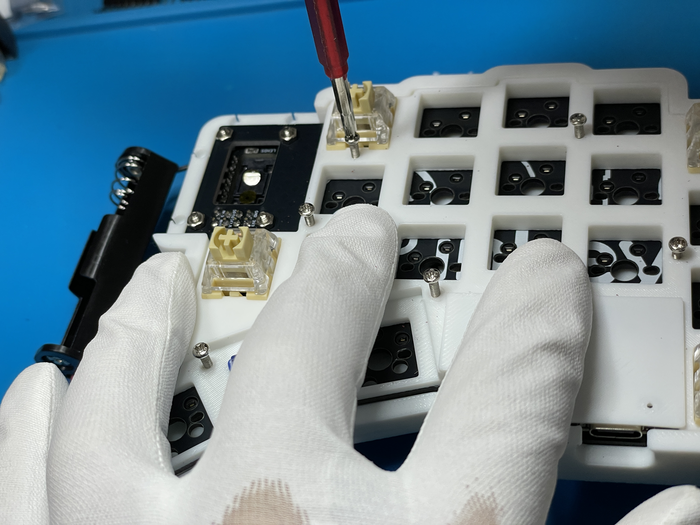
[picture p50: other/docs/buildguide/image/IMG_5583.JPG]


## 5.5 電池カバーケース
マグネットを6箇所装着します。印をつけた向きを確認し、接着剤等で装着します。※こちらは、穴のサイズは緩めです。
電池ケースを本体に近づけるようにしてリード線を中にしまい込み、電池カバーケースをマグネットで固定させます。

## 5.6 電源スイッチカバー
電源スチッチカバーを取り付けます。
電源は、内側（人差し指側）にスライドするとONになります。

## 5.7 トラックボールケース
付属のシャフト5mmにベアリングを通します。（ベアリングは別途ご準備ください。）
トラックボールケースの3箇所ベアリング装着用の溝がありますので、はめ込みます。
トラックボールケース側のマグネットを4箇所はめます。

同様に、右手ボトムケースのトラックボールケース設置箇所の縁の4箇所にマグネットを装着します。

PMW3610のレンズ保護がはずれており
PMW3610のレンズがはまっていることを確認してトラックボールケースを設置します。

# 6. キースイッチとキーキャップ
お好きなキースイッチとキーキャップをはめてください。

# 7. Bluetooth接続
電池ケースに電池をセットしてください。プラス極とマイナス極を間違えないようにしてください。
両方の電源スイッチを内側（人差し指側）にスライドしてください。
右手の最右下のキーを押しながら
左手の最左下のキーを押しながら
左手の最左上のキーのいずれか（Q、W、E、R、T）を押してください。
Bluetoothレイヤーのプロファイル0～4が割り当てられています。
ご利用される端末とお好きなプロファイル番号でペアリングを行ってください。

# 8. ファームウェアの書き換えとキーマップ変更
ファームウェアのファイルと、デフォルトキーマップを公開します。
.keymapファイルを変更し、ビルドして書き込み直して下さい。

ビルドの方法については、
購入者様へのDiscordチャンネルへ招待しますので
そちらでご相談ください。

# 9. トラブルシューティング
電池から異臭がする、または昇圧回路が熱くなっている場合はショートしている可能性があるため、テスターを使って導通チェックを行ってください。

# 10. Discordサーバ
Pinkeybdをご購入の方にDisocordの招待リンクを送らせていただきます。
そちらで困ったことがありましたら、ご相談いただければできる限り対応させていただきます。
