teraknights/Pinkeybd-forked/other/docs/buildguide/image/IMG_5451.JPG

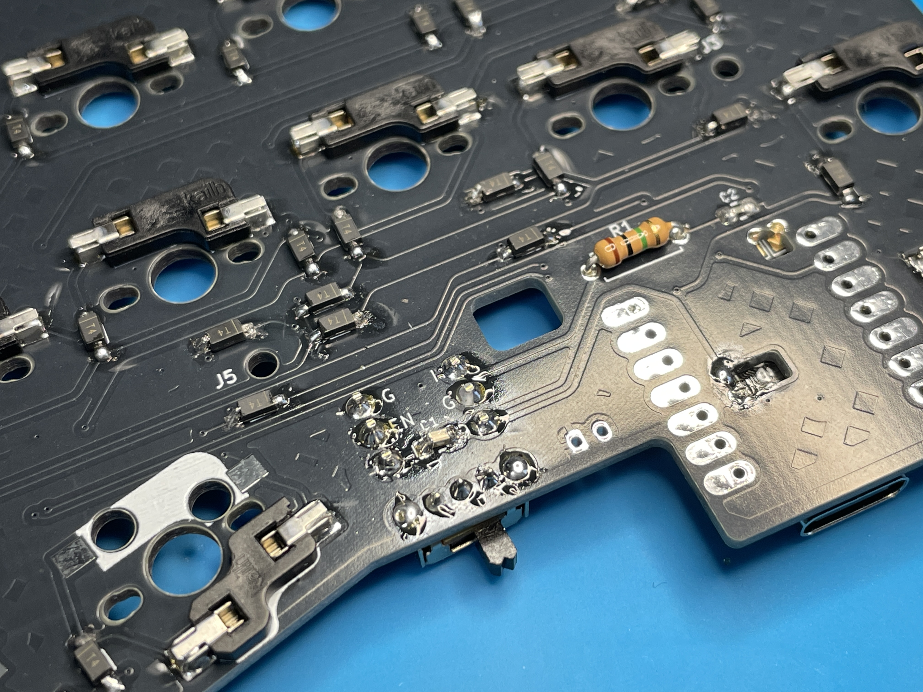
other/docs/buildguide/image/IMG_5451.JPG
