teraknights/Pinkeybd-forked/other/docs/buildguide/image/IMG_5454.JPG

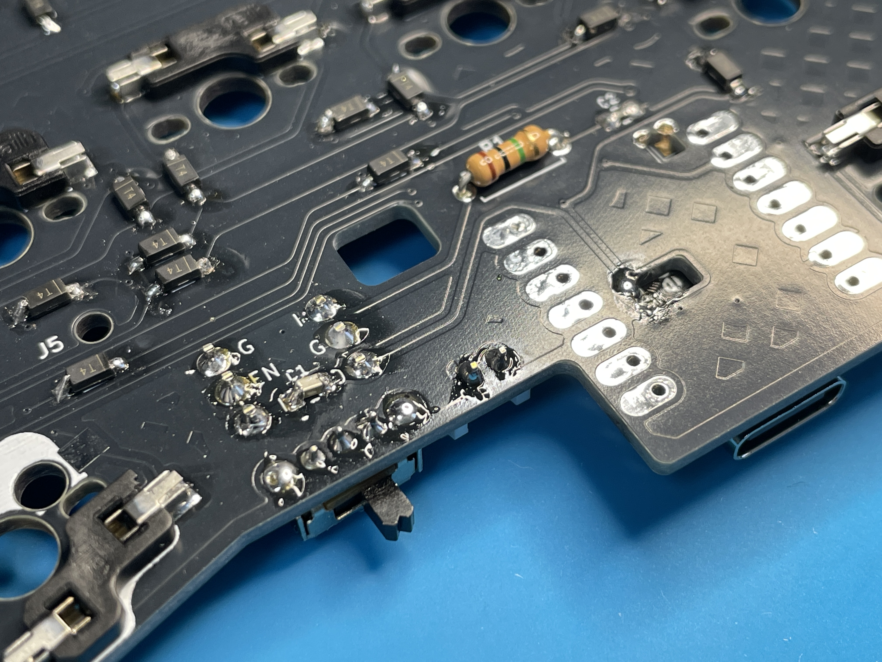
other/docs/buildguide/image/IMG_5454.JPG
