teraknights/Pinkeybd-forked/other/docs/buildguide/image/IMG_5455.JPG

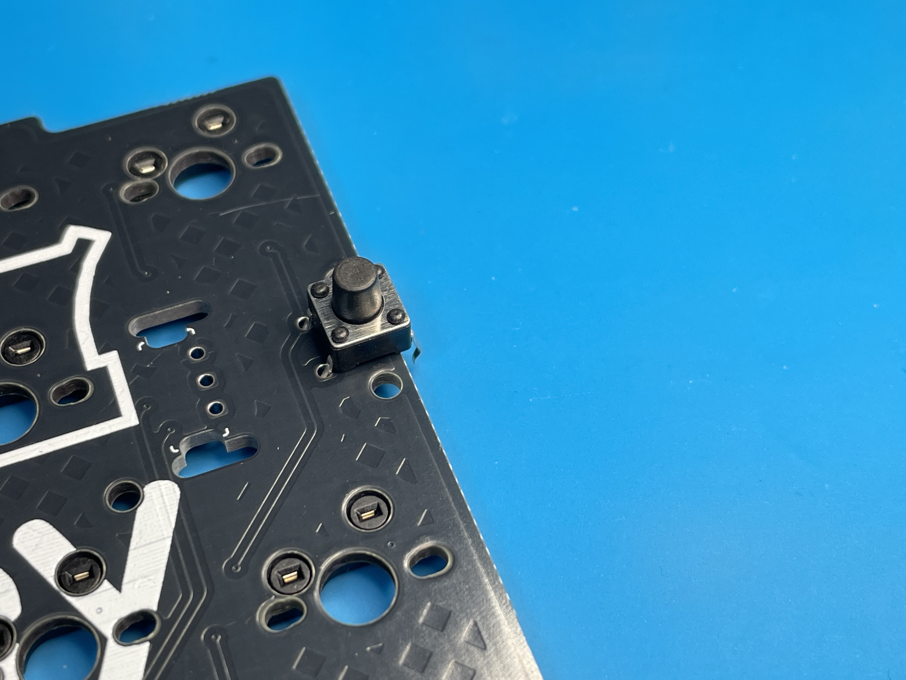
other/docs/buildguide/image/IMG_5455.JPG
