teraknights/Pinkeybd-forked/other/pcb/Left/ver2.3/pinkeybd_L.kicad_pcb

## KiCad design other/pcb/Left/ver2.3/pinkeybd_L.kicad_pcb (2026-01-10)

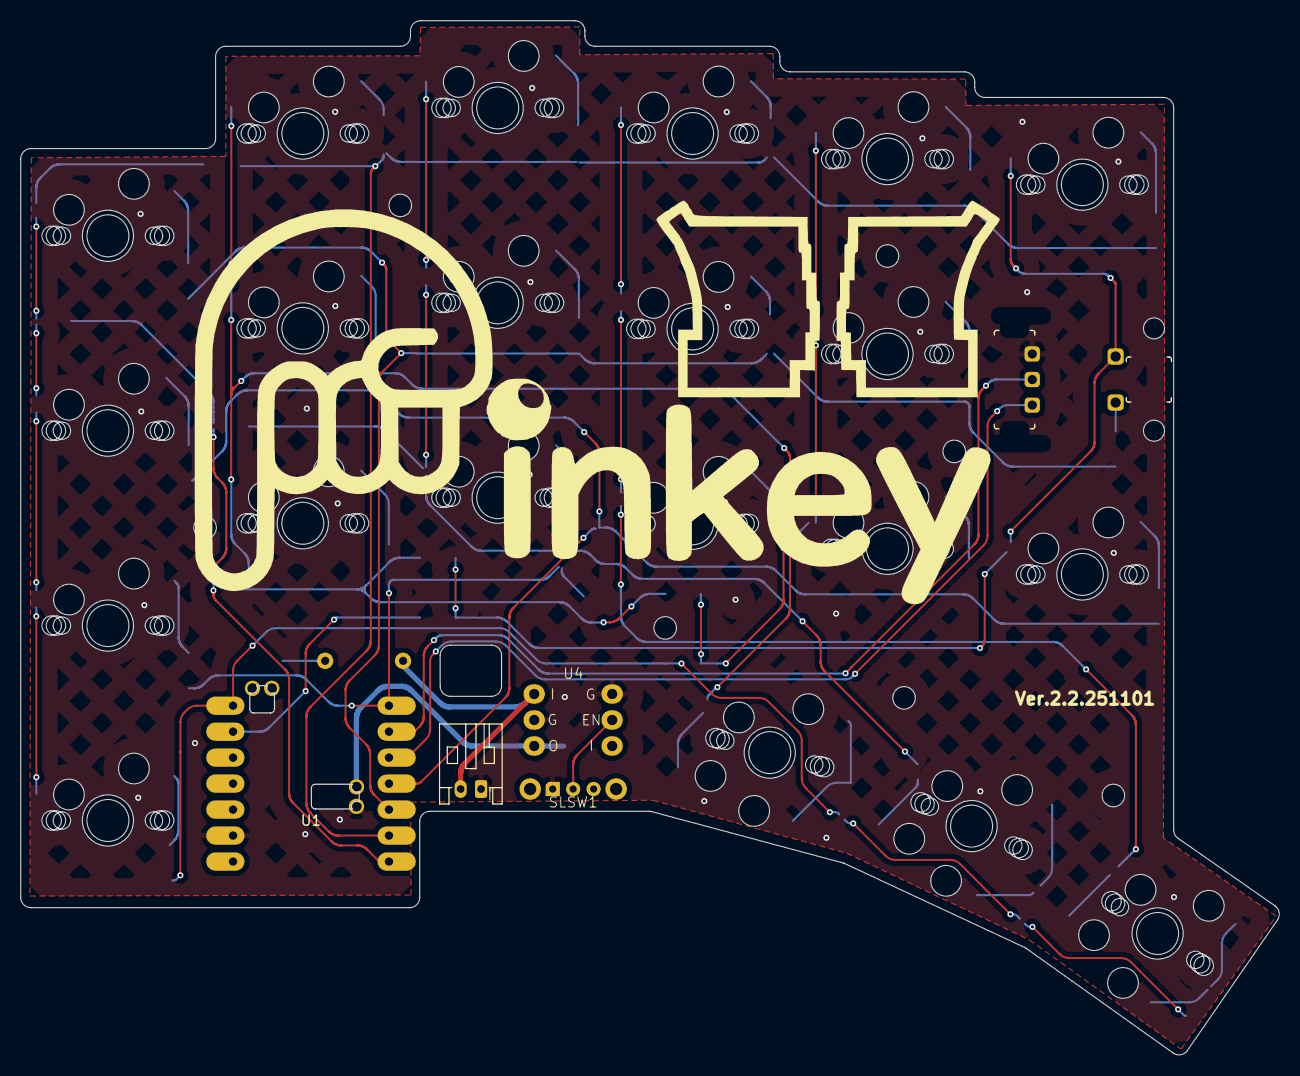
[picture p54: board pinkeybd_L.kicad_pcb from above]

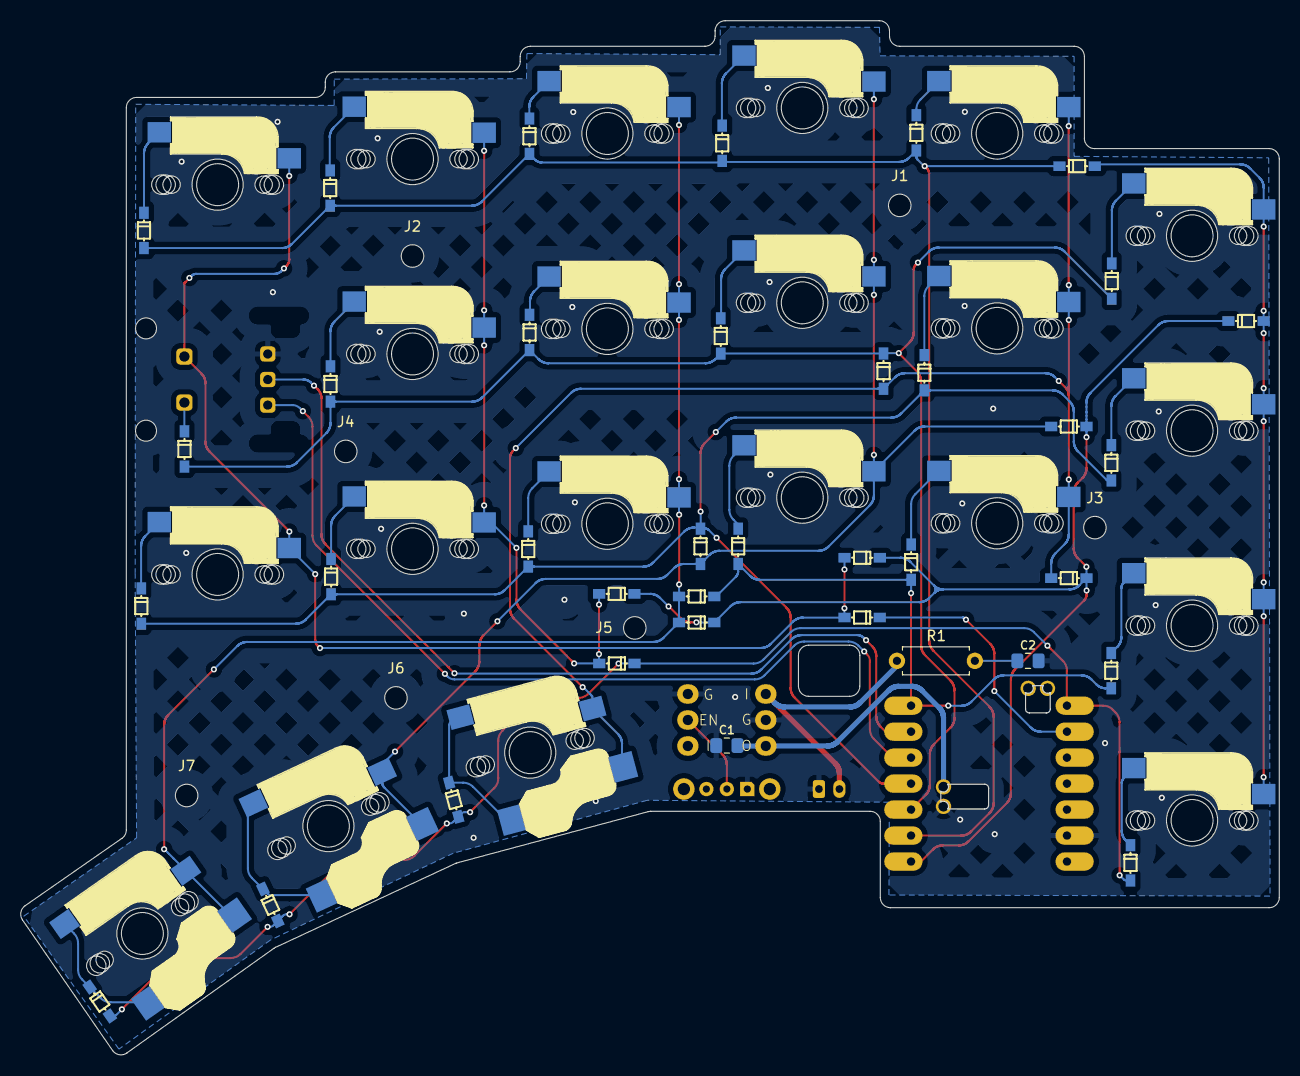
[picture p55: board pinkeybd_L.kicad_pcb from below]

Board: 2 copper layers, 123.0 x 101.1 mm, 68 parts (3 on the bottom side), 39 nets.

Parts:
C1: 47μF; C_0805_2012Metric_Pad1.18x1.45mm_HandSolder
C2: 1μF; C_0805_2012Metric_Pad1.18x1.45mm_HandSolder
D01, D02, D03, D04, D05, D10, D12, D13, D14, D15, D20, D21, D23, D24, D25, D30, D31, D32, D40, D41, D42, D43: 1N4148; Diode_SMD
DI1, DI2, DI3, DI4, DI5, DI6: 1N4148; Diode_SMD
DS1, DS2, DS3, DS4, DS5, DS6: 1N4148; Diode_SMD
J1, J2, J3, J4, J5, J6, J7: MountingHole_2.2mm_M2_DIN965
R1: 1M; R_Axial_DIN0207_L6.3mm_D2.5mm_P7.62mm_Horizontal
SLSW1: SK-12D11VG3; SW_Slide_SK-12D11VG3
SW: SW_PUSH; SW_MX
SW#2, SW#3, SW#4, SW#5, SW#6, SW#7, SW#8, SW#9, SW#10, SW#12, SW#13, SW#14, SW#15, SW#16, SW#17, SW#20, SW#21: SW_PUSH; SW_MX
SW#11, SW#18, SW#19: SW_PUSH; SW_MX_Choc
U1: XIAO_nRF52840_wBAT_wNFC_1
U4: DC/DC_Converter_XCL103; DC_DC_Converter_XCL103

Connections:
Bat: R1.1, U4.4
EN: SLSW1.2, U4.2
GND: C1.1, C2.2, SLSW1.1, U1.13 (GND), U1.21 (BATT-), U4.3, U4.5
INTR: DI1.1 (K), DI2.1 (K), DI3.1 (K), DI4.1 (K), DI5.1 (K), DI6.1 (K), U1.1 (P0.02_A0_D0)
IO1: D01.2 (A), D02.2 (A), D03.2 (A), D04.2 (A), D05.2 (A), DS1.1 (K), U1.2 (P0.03_A1_D1)
IO2: D10.2 (A), D12.2 (A), D13.2 (A), D14.2 (A), D15.2 (A), DS2.1 (K), U1.3 (P0.28_A2_D2)
IO3: D20.2 (A), D21.2 (A), D23.2 (A), D24.2 (A), D25.2 (A), DS3.1 (K), U1.4 (P0.29_A3_D3)
IO4: D30.2 (A), D31.2 (A), D32.2 (A), DS4.1 (K), U1.7 (P1.11_D6_TX)
IO5: D40.2 (A), D41.2 (A), D42.2 (A), D43.2 (A), DS5.1 (K), U1.8 (P1.12_D7_RX)
IO6: DS6.1 (K), U1.9 (P1.13_D8_SCK)
unnamed: C2.1, R1.2
unnamed: D01.1 (K), SW#2.2
unnamed: D02.1 (K), SW#21.2
unnamed: D03.1 (K), SW#7.2
unnamed: D04.1 (K), SW.2
unnamed: D05.1 (K), SW#9.2
unnamed: D10.1 (K), SW#4.2
unnamed: D12.1 (K), SW#15.2
unnamed: D13.1 (K), SW#13.2
unnamed: D14.1 (K), SW#12.2
unnamed: D20.1 (K), SW#17.2
unnamed: D21.1 (K), SW#14.2
unnamed: D23.1 (K), SW#6.2
unnamed: D24.1 (K), SW#10.2
unnamed: D25.1 (K), SW#8.2
unnamed: D30.1 (K), SW#16.2
unnamed: D31.1 (K), SW#5.2
unnamed: D32.1 (K), SW#3.2
unnamed: D40.1 (K), SW#20.2
unnamed: D41.1 (K), SW#11.2
unnamed: D42.1 (K), SW#18.2
unnamed: D43.1 (K), SW#19.2
unnamed: DI1.2 (A), DS1.2 (A), SW#4.1, SW#16.1, SW#17.1, SW#20.1
unnamed: DI2.2 (A), DS2.2 (A), SW#2.1, SW#5.1, SW#11.1, SW#14.1
unnamed: DI3.2 (A), DS3.2 (A), SW#3.1, SW#15.1, SW#18.1, SW#21.1
unnamed: DI4.2 (A), DS4.2 (A), SW#6.1, SW#7.1, SW#13.1, SW#19.1
unnamed: DI5.2 (A), DS5.2 (A), SW.1, SW#10.1, SW#12.1
unnamed: DI6.2 (A), DS6.2 (A), SW#8.1, SW#9.1
Vout: C1.2, U1.20 (BATT+), U4.6
