teraknights/Pinkeybd-forked/other/pcb/right/ver2.1/pinkeybd_R.kicad_pcb

## KiCad design other/pcb/right/ver2.1/pinkeybd_R.kicad_pcb (2026-01-10)

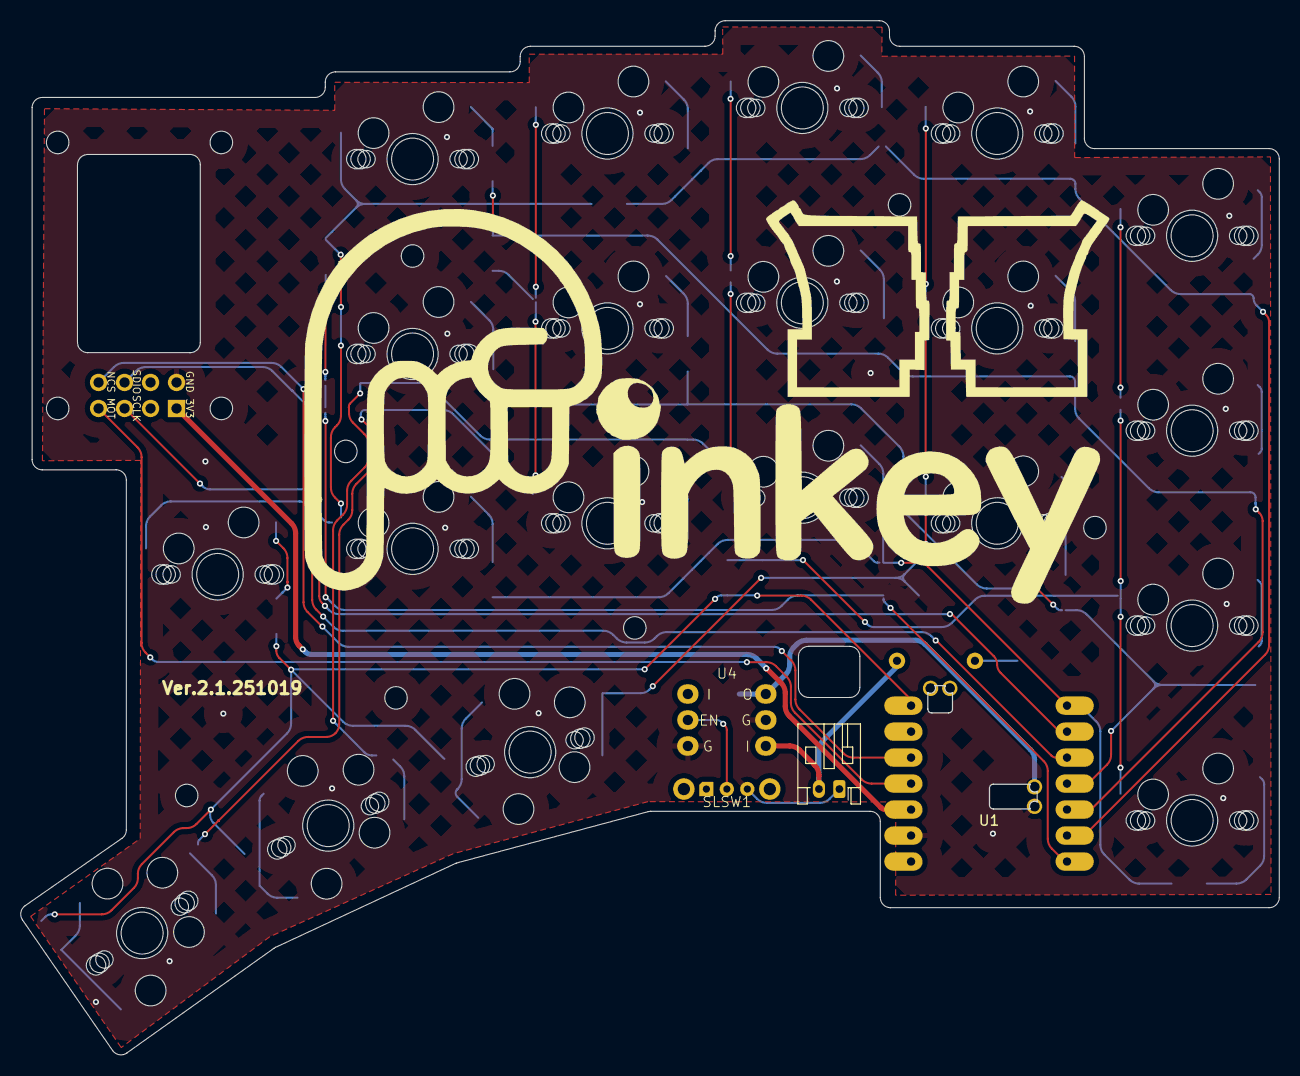
[picture p56: board pinkeybd_R.kicad_pcb from above]

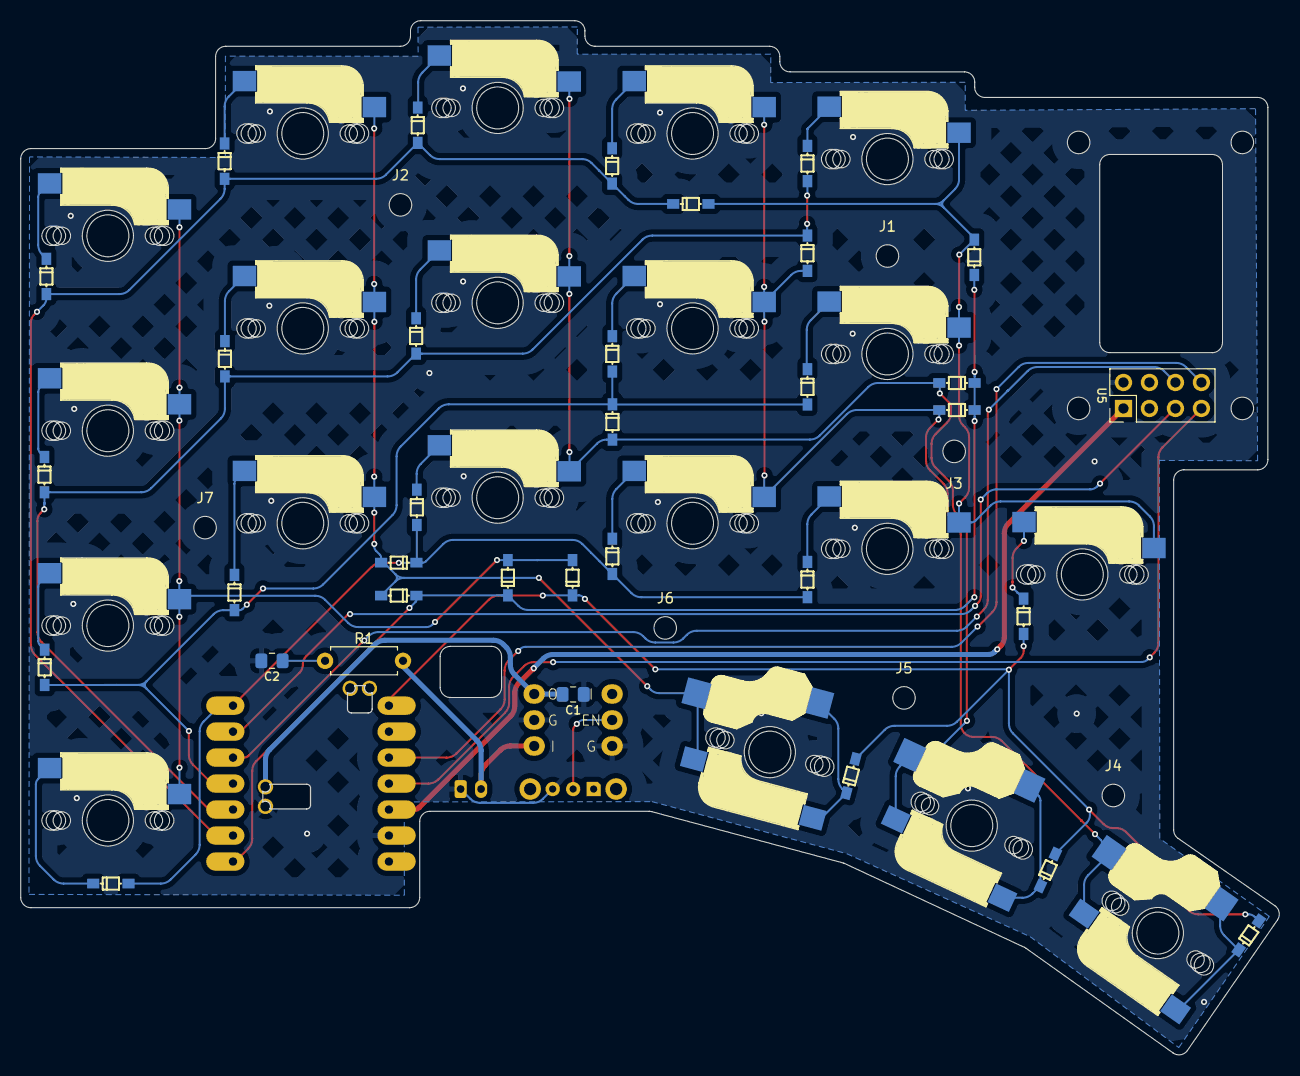
[picture p57: board pinkeybd_R.kicad_pcb from below]

Board: 2 copper layers, 123.0 x 101.1 mm, 68 parts (8 on the bottom side), 41 nets.

Parts:
C1: 47μF; C_0805_2012Metric_Pad1.18x1.45mm_HandSolder
C2: 1μF; C_0805_2012Metric_Pad1.18x1.45mm_HandSolder
D61, D62, D63, D64, D70, D72, D73, D74, D80, D81, D83, D84, D90, D91, D92, D94: 1N4148; Diode_SMD
DA0, DA1, DA2, DA3: 1N4148; Diode_SMD
DI7, DI8, DI9, DI10, DI11: 1N4148; Diode_SMD
DS7, DS8, DS9, DS10, DS11: 1N4148; Diode_SMD
H1, H2, H3, H4: MountingHole; MountingHole_2.2mm_M2_DIN965
J1, J2, J3, J4, J5, J6, J7: Conn_01x01-Connector_Generic; MountingHole_2.2mm_M2_DIN965
R1: 1M; R_Axial_DIN0207_L6.3mm_D2.5mm_P7.62mm_Horizontal
SLSW1: SK-12D11VG3; SW_Slide_SK-12D11VG3
SW: SW_PUSH; SW_MX
SW#2, SW#3, SW#4, SW#5, SW#6, SW#7, SW#9, SW#10, SW#11, SW#12, SW#14, SW#15, SW#16, SW#17, SW#18, SW#20: SW_PUSH; SW_MX
SW#8, SW#13, SW#19: SW_PUSH; SW_MX_Choc
U1: XIAO_nRF52840_wBAT_wNFC_1
U4: DC_DC_Converter_XCL103
U5: Conn_02x04_Odd_Even; PinHeader_2x04_P2.54mm_Vertical

Connections:
3.3V: U1.12 (3V3), U5.1
Bat: R1.1, U4.4 (IN)
EN: SLSW1.2, U4.2 (EN)
GND: C1.1, C2.2, SLSW1.3, U1.13 (GND), U1.21 (BATT-), U4.3 (GND), U4.5 (GND), U5.2
INTR: DI7.1 (K), DI8.1 (K), DI9.1 (K), DI10.1 (K), DI11.1 (K), U1.1 (P0.02_A0_D0)
IO1: D61.2 (A), D62.2 (A), D63.2 (A), D64.2 (A), DS7.1 (K), U1.2 (P0.03_A1_D1)
IO2: D70.2 (A), D72.2 (A), D73.2 (A), D74.2 (A), DS8.1 (K), U1.3 (P0.28_A2_D2)
IO3: D80.2 (A), D81.2 (A), D83.2 (A), D84.2 (A), DS9.1 (K), U1.4 (P0.29_A3_D3)
IO4: D90.2 (A), D91.2 (A), D92.2 (A), D94.2 (A), DS10.1 (K), U1.7 (P1.11_D6_TX)
IO5: DA0.2 (A), DA1.2 (A), DA2.2 (A), DA3.2 (A), DS11.1 (K), U1.8 (P1.12_D7_RX)
MOTION: U1.11 (P1.15_D10_MOSI), U5.7
NCS: U1.10 (P1.14_D9_MISO), U5.8
unnamed: C2.1, R1.2
unnamed: D61.1 (K), SW#6.2
unnamed: D62.1 (K), SW#18.2
unnamed: D63.1 (K), SW#17.2
unnamed: D64.1 (K), SW.2
unnamed: D70.1 (K), SW#12.2
unnamed: D72.1 (K), SW#15.2
unnamed: D73.1 (K), SW#16.2
unnamed: D74.1 (K), SW#3.2
unnamed: D80.1 (K), SW#5.2
unnamed: D81.1 (K), SW#7.2
unnamed: D83.1 (K), SW#20.2
unnamed: D84.1 (K), SW#11.2
unnamed: D90.1 (K), SW#9.2
unnamed: D91.1 (K), SW#10.2
unnamed: D92.1 (K), SW#14.2
unnamed: D94.1 (K), SW#2.2
unnamed: DA0.1 (K), SW#4.2
unnamed: DA1.1 (K), SW#19.2
unnamed: DA2.1 (K), SW#13.2
unnamed: DA3.1 (K), SW#8.2
unnamed: DI7.2 (A), DS7.2 (A), SW#4.1, SW#5.1, SW#9.1, SW#12.1
unnamed: DI8.2 (A), DS8.2 (A), SW#6.1, SW#7.1, SW#10.1, SW#19.1
unnamed: DI9.2 (A), DS9.2 (A), SW#13.1, SW#14.1, SW#15.1, SW#18.1
unnamed: DI10.2 (A), DS10.2 (A), SW#8.1, SW#16.1, SW#17.1, SW#20.1
unnamed: DI11.2 (A), DS11.2 (A), SW.1, SW#2.1, SW#3.1, SW#11.1
SCLK: U1.6 (P0.05_A5_D5_SCL), U5.5
SDIO: U1.5 (P0.04_A4_D4_SDA), U5.6
Vout: C1.2, U1.20 (BATT+), U4.6 (OUT)
