teraknights/Pinkeybd-forked/other/docs/buildguide/image/IMG_5516.JPG

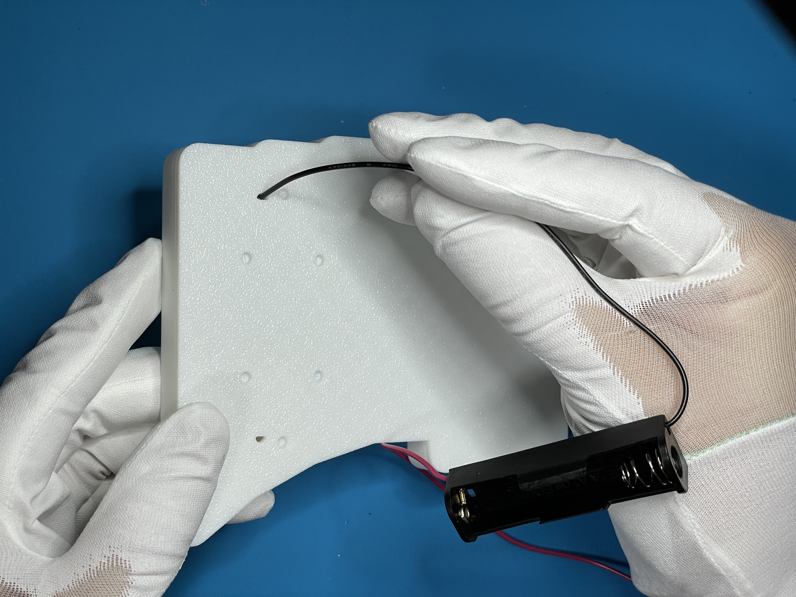
[picture p38: other/docs/buildguide/image/IMG_5516.JPG]
other/docs/buildguide/image/IMG_5516.JPG
