teraknights/Pinkeybd-forked/other/docs/buildguide/image/IMG_5540.JPG

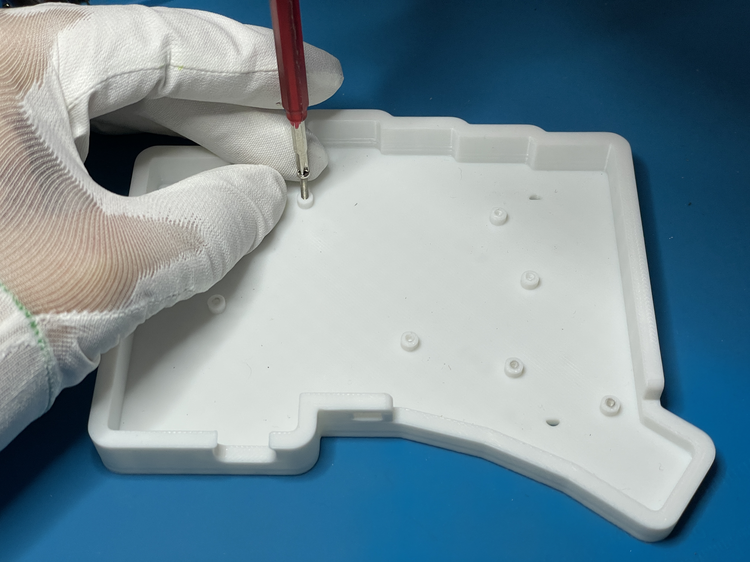
[picture p43: other/docs/buildguide/image/IMG_5540.JPG]
other/docs/buildguide/image/IMG_5540.JPG
